radmilofelix/ElectronicFocuser/Schematic&PCB/KiCad/Regulus Focuser-V1.remote/Images/Focuser-V1.Remote-3D_View.jpg

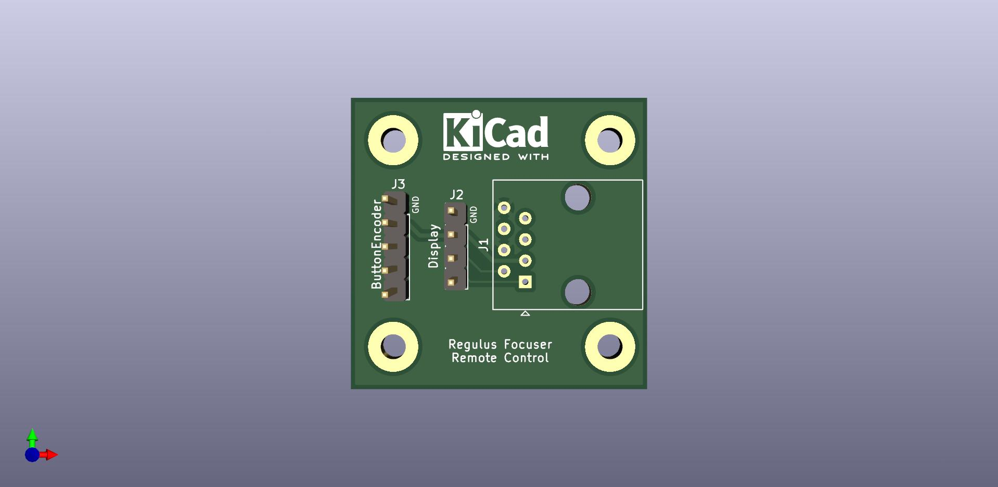
Schematic&PCB/KiCad/Regulus Focuser-V1.remote/Images/Focuser-V1.Remote-3D_View.jpg
