radmilofelix/ElectronicFocuser/Schematic&PCB/PCB/RegulusFocuser-V1.0.jpg

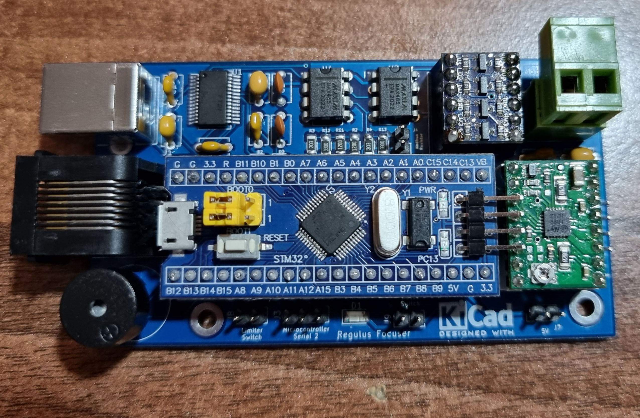
Schematic&PCB/PCB/RegulusFocuser-V1.0.jpg
