radmilofelix/ElectronicFocuser/README.md

# ElectronicFocuser
 Electronic focuser with stepper motor for telescopes
