radmilofelix/ElectronicFocuser/Schematic&PCB/KiCad/Regulus Focuser-V1.1/Errors&Enhancements/Errors&Enhancements.odt

The resistors on the i2c lines (2.2k) are pulldown instead of pullup.
