radmilofelix/ElectronicFocuser/Documents/StepperMotorDriversPinout.xlsx

A4988 | DRV8825 | STSPIN220 | STSPIN820 | STSPIN820 | STSPIN220 | DRV8825 | A4988
-ENABLE | -ENABLE | -ENABLE | -ENABLE | VMOT | VMOT | VMOT | VMOT
MS1 | M0 | MODE1 | M1 | GND | GND | GND | GND
MS2 | M1 | MODE2 | M2 | B1 | B1 | B2 | 2B
MS3 | M2 | 1 | M3 | B2 | B2 | B1 | 2A
-RESET | -RESET | 2 | -FLT | A2 | A2 | A1 | 1A
-SLEEP | -SLEEP | -STBY | -STBY | A1 | A1 | A2 | 1B
STEP | STEP | STEP/MODE3 | STEP | VCC | VCC | -FAULT [VCC] | VDD
DIR | DIR | DIR/MODE4 | DIR | GND | GND | GND | GND
