radmilofelix/ElectronicFocuser/Schematic&PCB/KiCad/Regulus Focuser-V1/Errors&Enhancements/Errors&Enhancements.odt

There are routing errors – MC pins 2, 3, 4, 6, 7, 26, 27, 28, 29, 30, 31, 32

Add details for logic level shifter, 5V pins, serial pins, motor driver pins

Add pullup resistors on the i2c lines (2.2k).

Add decoupling capacitor on the limiter switch 2.2 uF

Power from 12v to 5V ???
