radmilofelix/ElectronicFocuser/MechanicalDesigns-FreeCad/2 inch Crayford Focuser for Schmidt Cassegrain/SwitchHolders/BigMicroswitch/D3V-16-1C5/D3V-16-1C5.jpg

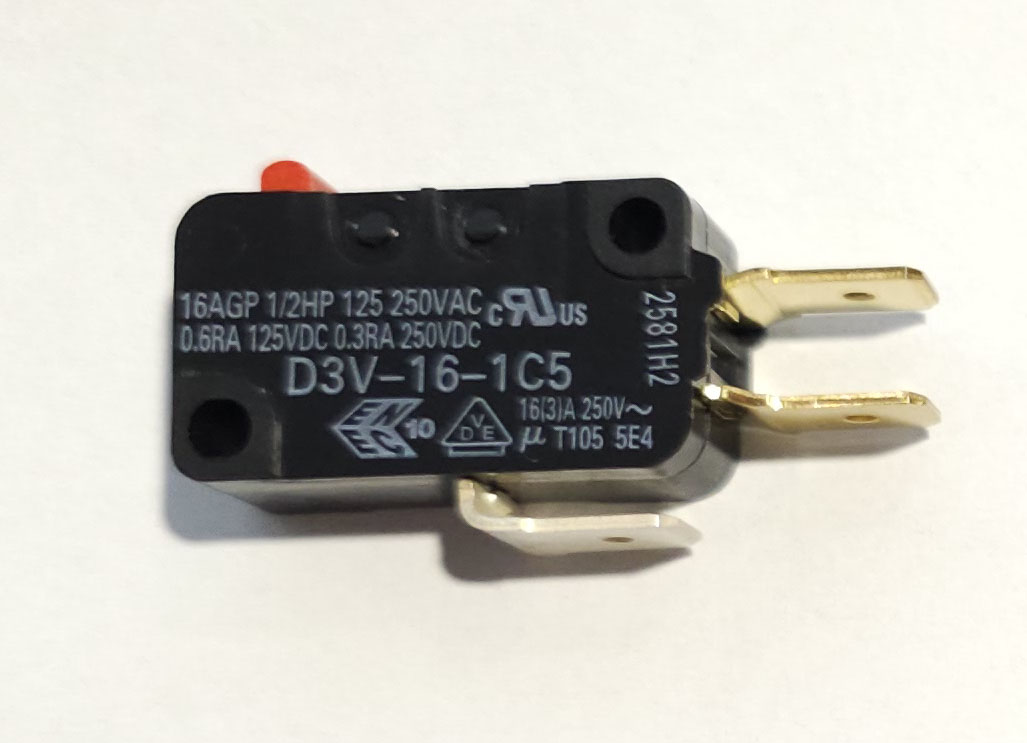
MechanicalDesigns-FreeCad/2 inch Crayford Focuser for Schmidt Cassegrain/SwitchHolders/BigMicroswitch/D3V-16-1C5/D3V-16-1C5.jpg
