radmilofelix/ElectronicFocuser/MechanicalDesigns-FreeCad/2 inch Crayford Focuser for Schmidt Cassegrain/SwitchHolders/BigMicroswitch/D3V-162-1A4/D3V-162-1A4.jpg

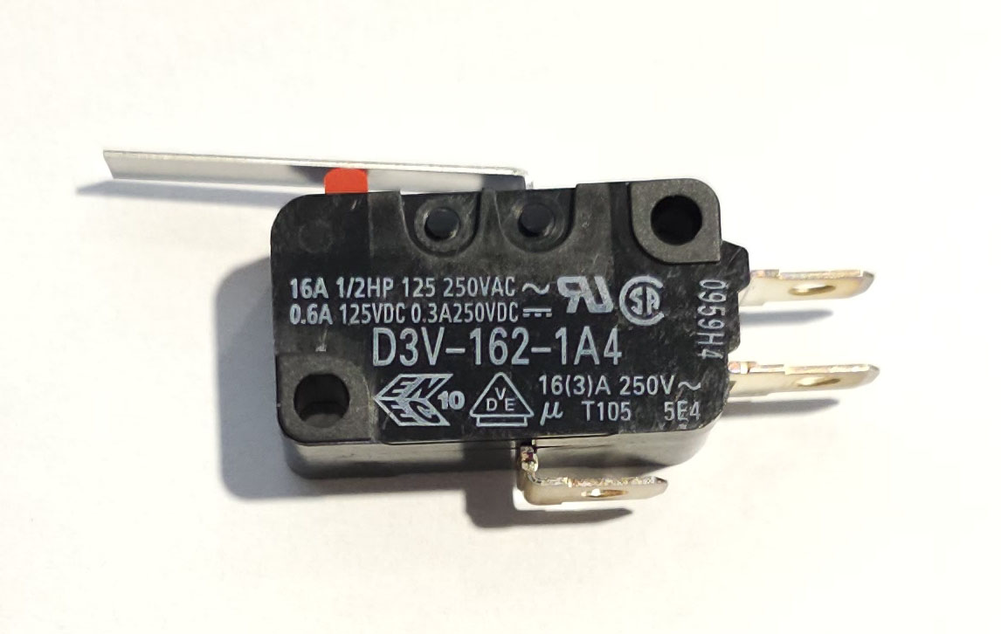
MechanicalDesigns-FreeCad/2 inch Crayford Focuser for Schmidt Cassegrain/SwitchHolders/BigMicroswitch/D3V-162-1A4/D3V-162-1A4.jpg
