radmilofelix/ElectronicFocuser/MechanicalDesigns-FreeCad/2 inch Crayford Focuser for Schmidt Cassegrain/SwitchHolders/MediumMicroswitch/SS-X-GL/SS-X-GL.jpg

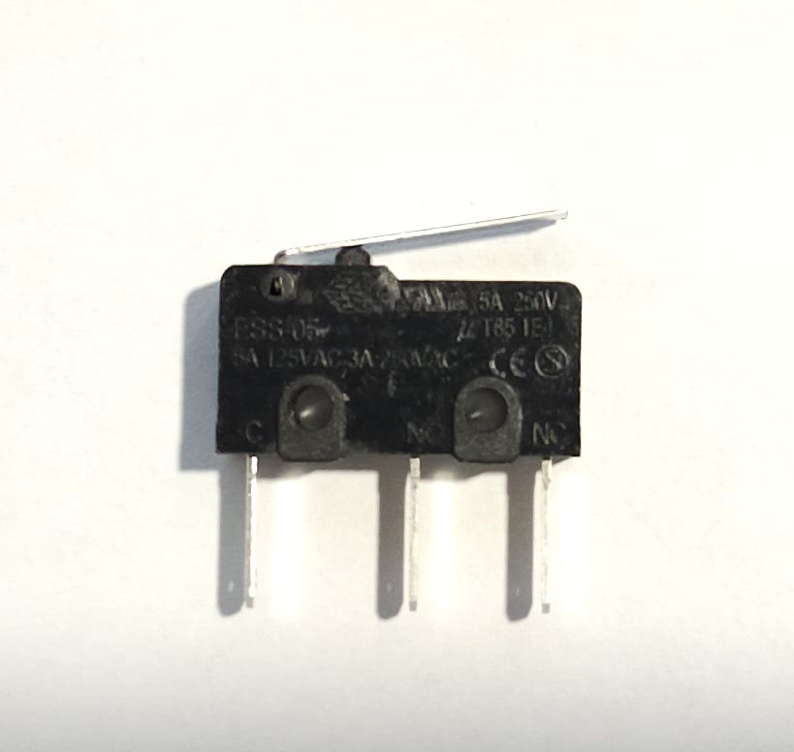
MechanicalDesigns-FreeCad/2 inch Crayford Focuser for Schmidt Cassegrain/SwitchHolders/MediumMicroswitch/SS-X-GL/SS-X-GL.jpg
