radmilofelix/ElectronicFocuser/MechanicalDesigns-FreeCad/2 inch Crayford Focuser for Schmidt Cassegrain/SwitchHolders/MediumMicroswitch/SS-X/SS-X.jpg

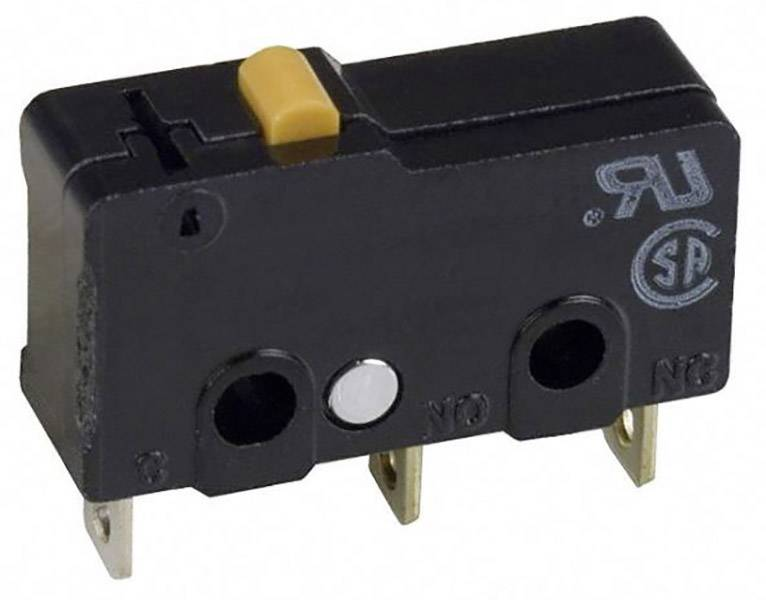
MechanicalDesigns-FreeCad/2 inch Crayford Focuser for Schmidt Cassegrain/SwitchHolders/MediumMicroswitch/SS-X/SS-X.jpg
