radmilofelix/ElectronicFocuser/MechanicalDesigns-FreeCad/2 inch Crayford Focuser for Schmidt Cassegrain/SwitchHolders/SmallMicroswitch/D2F-L/D2F-L.jpg

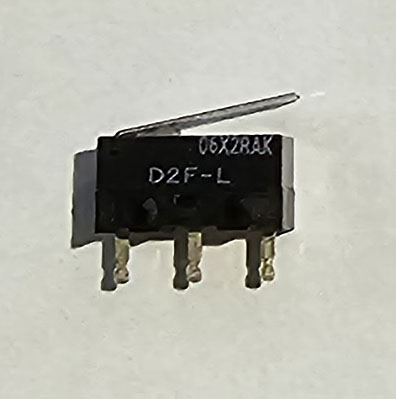
MechanicalDesigns-FreeCad/2 inch Crayford Focuser for Schmidt Cassegrain/SwitchHolders/SmallMicroswitch/D2F-L/D2F-L.jpg
