radmilofelix/ElectronicFocuser/Schematic&PCB/KiCad/Regulus Focuser-V1.1/Errors&Enhancements/I2C-resistorsChangedToPullup.jpg

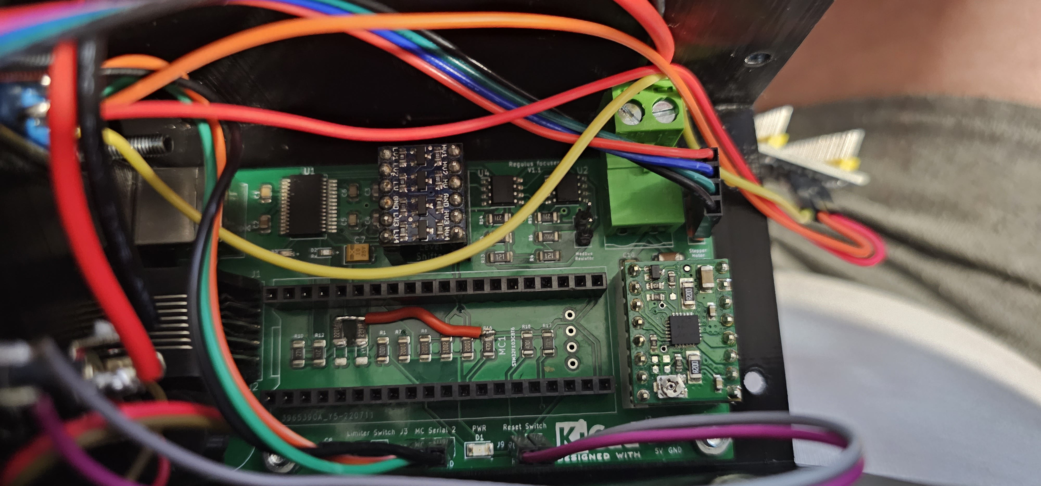
Schematic&PCB/KiCad/Regulus Focuser-V1.1/Errors&Enhancements/I2C-resistorsChangedToPullup.jpg
