radmilofelix/ElectronicFocuser/Schematic&PCB/PCB/PCB-V1.1-fixed.jpg

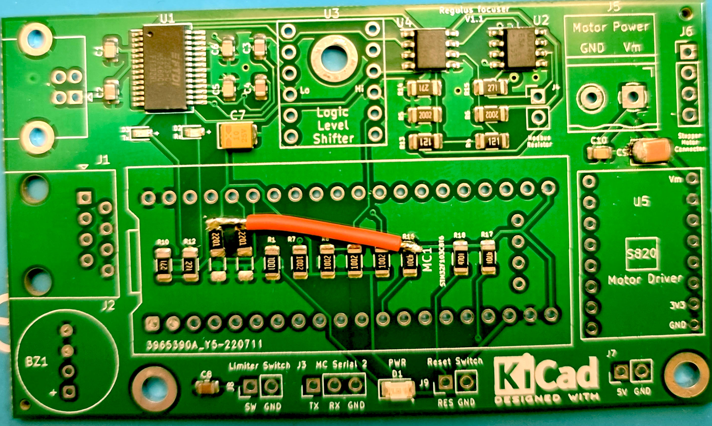
Schematic&PCB/PCB/PCB-V1.1-fixed.jpg
