radmilofelix/ElectronicFocuser/Schematic&PCB/PCB/PCB-V1.1.jpg

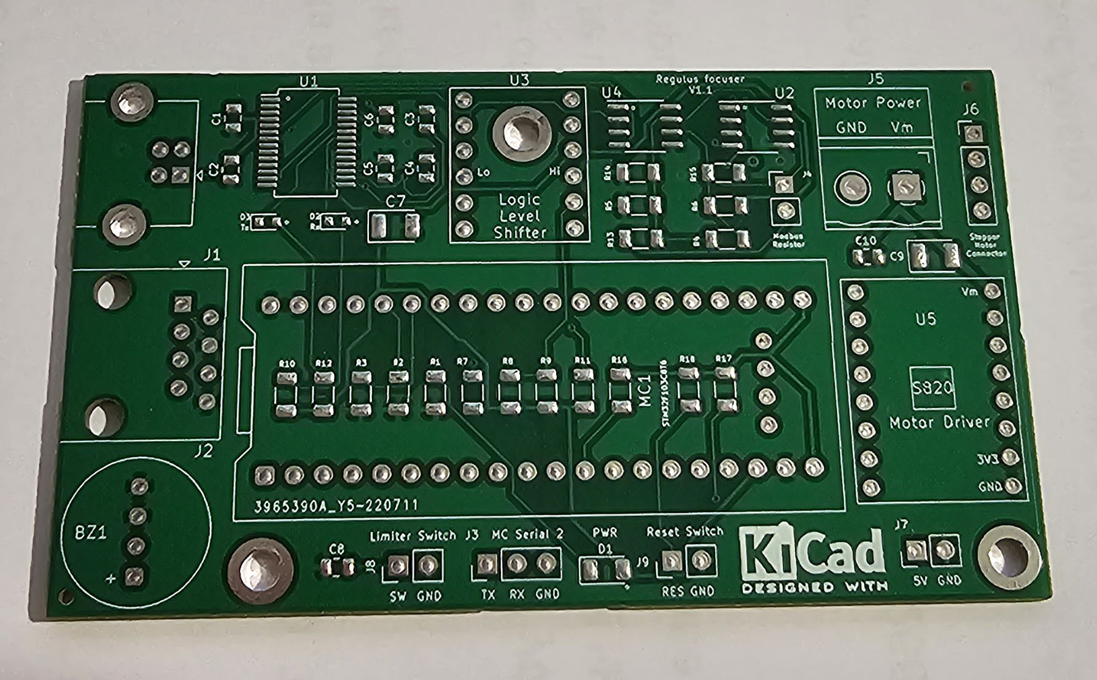
Schematic&PCB/PCB/PCB-V1.1.jpg
