radmilofelix/ElectronicFocuser/Schematic&PCB/PCB/RemoteControl-Back.jpg

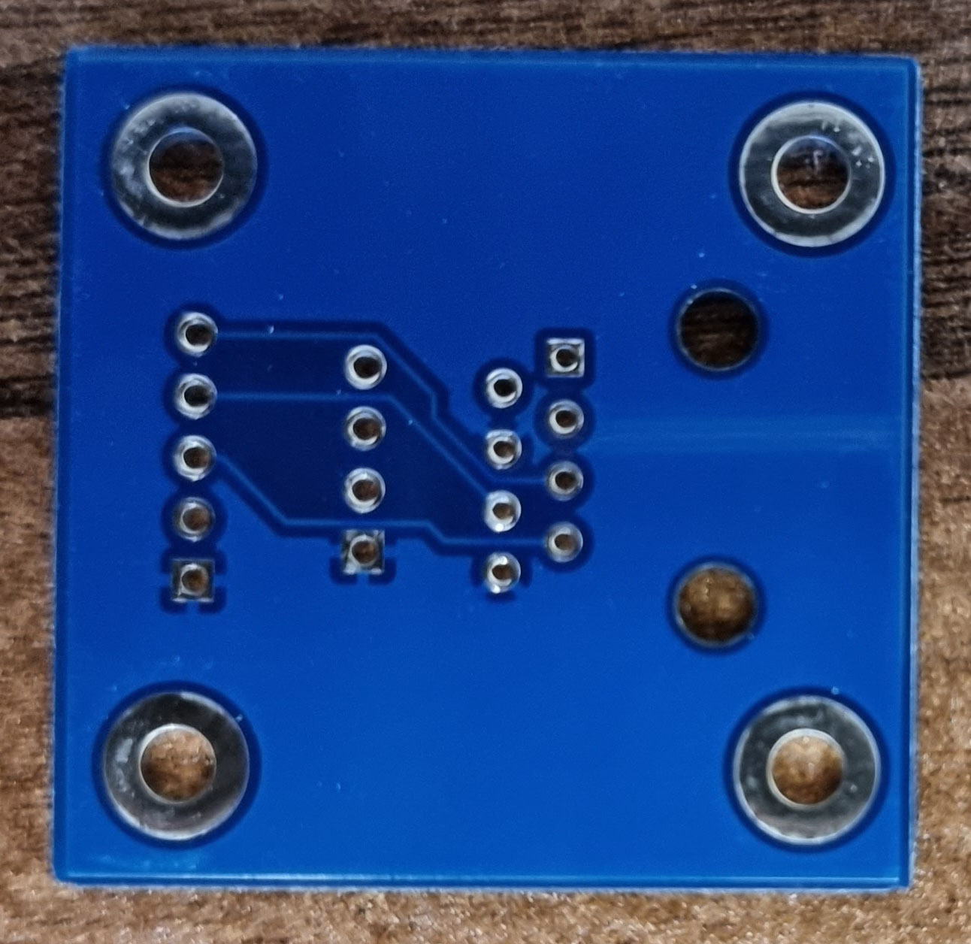
Schematic&PCB/PCB/RemoteControl-Back.jpg
