radmilofelix/ElectronicFocuser/Schematic&PCB/PCB/RemoteControl-Front.jpg

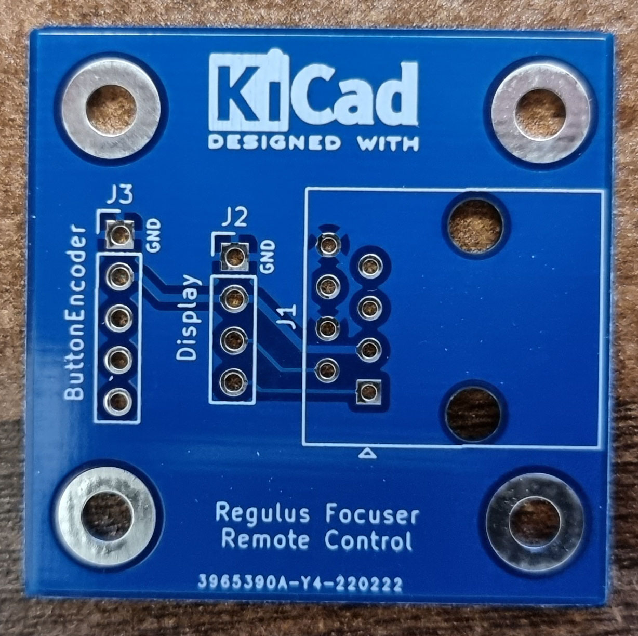
Schematic&PCB/PCB/RemoteControl-Front.jpg
