radmilofelix/ElectronicFocuser/MechanicalDesigns-FreeCad/2 inch Crayford Focuser for Schmidt Cassegrain/Case-MainPart.FCStd

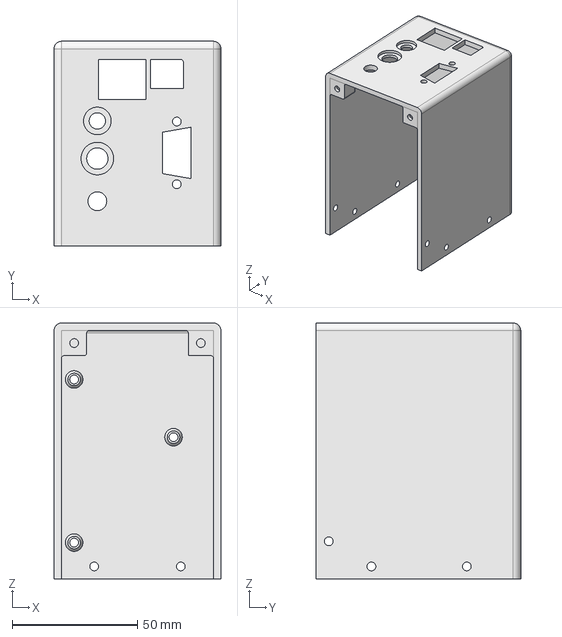
[picture p13: CAD file, 2023-12-28]
MechanicalDesigns-FreeCad/2 inch Crayford Focuser for Schmidt Cassegrain/Case-MainPart.FCStd
66.5 x 81.5 x 102.0 mm
