radmilofelix/ElectronicFocuser/MechanicalDesigns-FreeCad/Newt-254-F_4-RackAndPinion-LowProfile-focuser/Case-MainPart.FCStd

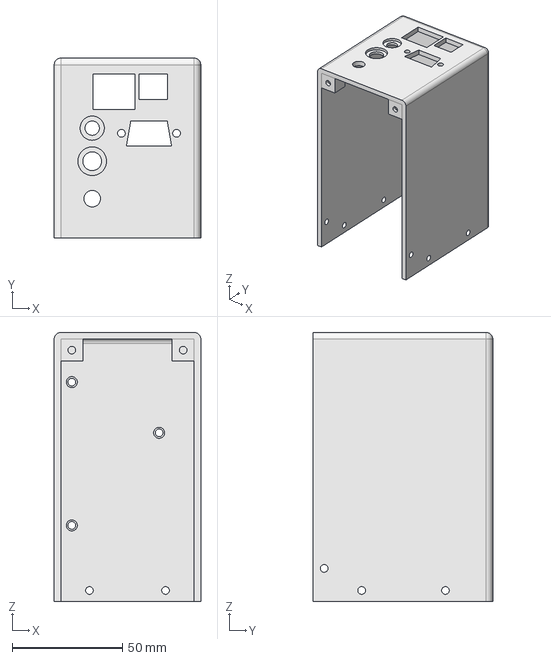
[picture p14: CAD file, 2023-12-28]
MechanicalDesigns-FreeCad/Newt-254-F_4-RackAndPinion-LowProfile-focuser/Case-MainPart.FCStd
66.5 x 81.5 x 122.0 mm
