radmilofelix/ElectronicFocuser/MechanicalDesigns-FreeCad/Newt-254-F_4-RackAndPinion-LowProfile-focuser/Case-MainPart-Work.FCStd

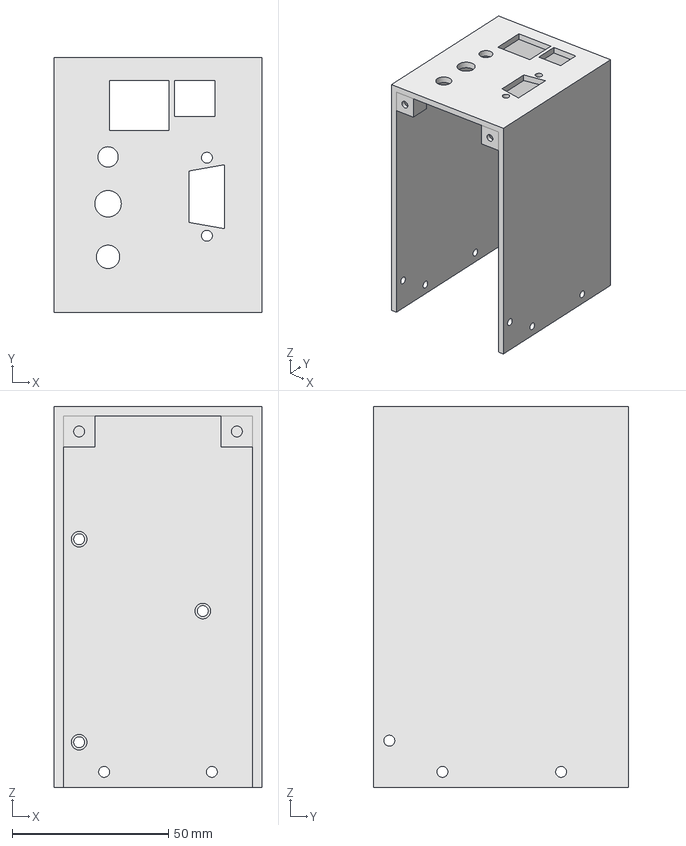
[picture p15: CAD file, 2023-12-28]
MechanicalDesigns-FreeCad/Newt-254-F_4-RackAndPinion-LowProfile-focuser/Case-MainPart-Work.FCStd
66.5 x 81.5 x 122.0 mm
