radmilofelix/ElectronicFocuser/MechanicalDesigns-FreeCad/2 inch Crayford Focuser for Schmidt Cassegrain/SwitchHolders/BigMicroswitch/D3V-16-1C5/SwitchHolderPerpendicular-D3V-15-1C5-Body.stl

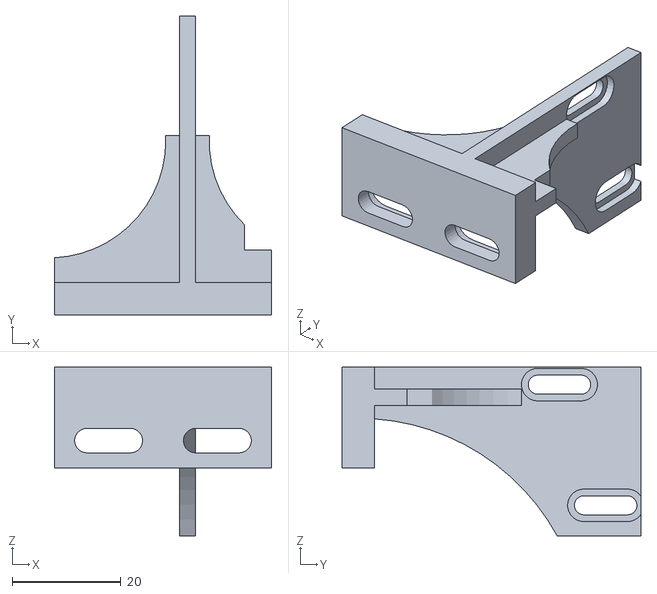
[picture p16: CAD file, 2023-06-21]
MechanicalDesigns-FreeCad/2 inch Crayford Focuser for Schmidt Cassegrain/SwitchHolders/BigMicroswitch/D3V-16-1C5/SwitchHolderPerpendicular-D3V-15-1C5-Body.stl
40.0 x 55.0 x 31.0
