radmilofelix/ElectronicFocuser/MechanicalDesigns-FreeCad/2 inch Crayford Focuser for Schmidt Cassegrain/SwitchHolders/BigMicroswitch/D3V-162-1A4/SwitchHolderPerpendicular-D3V-162-1A4-Body.stl

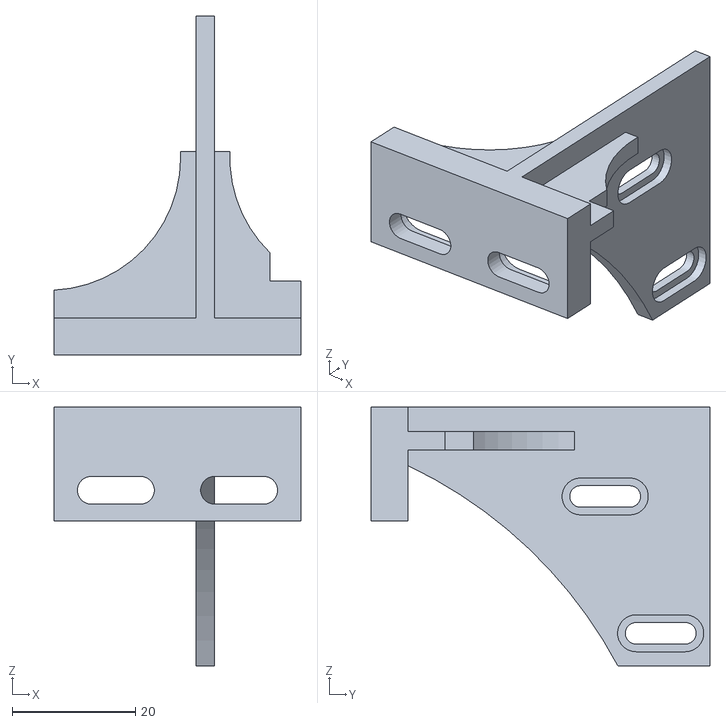
[picture p17: CAD file, 2023-06-21]
MechanicalDesigns-FreeCad/2 inch Crayford Focuser for Schmidt Cassegrain/SwitchHolders/BigMicroswitch/D3V-162-1A4/SwitchHolderPerpendicular-D3V-162-1A4-Body.stl
40.0 x 55.0 x 42.0
