radmilofelix/ElectronicFocuser/MechanicalDesigns-FreeCad/2 inch Crayford Focuser for Schmidt Cassegrain/SwitchHolders/MediumMicroswitch/SS-X-GL/SwitchHolderPerpendicular-SS-X-GL.FCStd

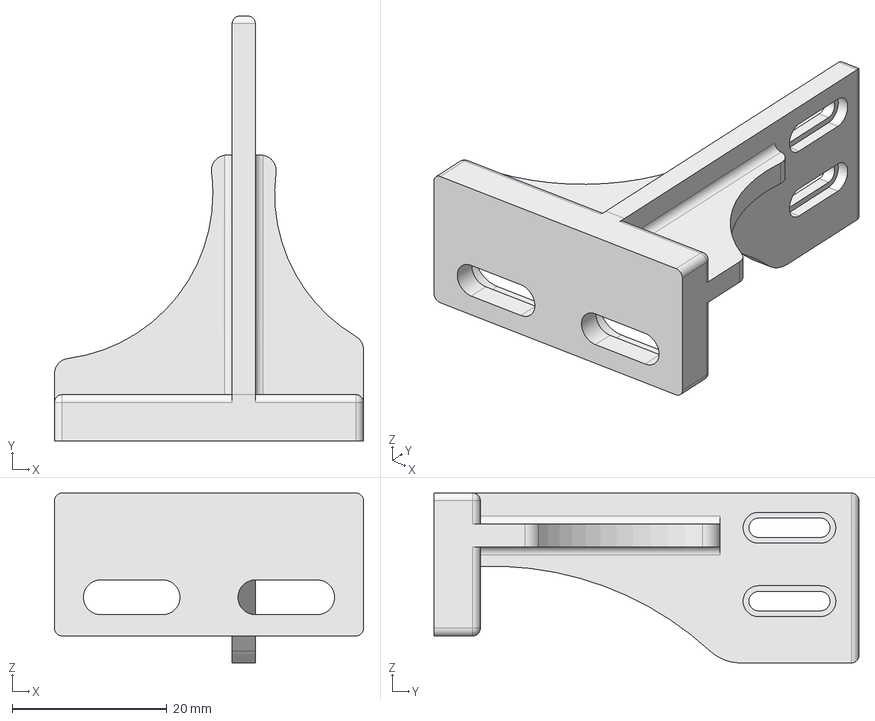
[picture p18: CAD file, 2023-06-21]
MechanicalDesigns-FreeCad/2 inch Crayford Focuser for Schmidt Cassegrain/SwitchHolders/MediumMicroswitch/SS-X-GL/SwitchHolderPerpendicular-SS-X-GL.FCStd
40.0 x 55.0 x 22.0 mm
