radmilofelix/ElectronicFocuser/MechanicalDesigns-FreeCad/2 inch Crayford Focuser for Schmidt Cassegrain/SwitchHolders/MediumMicroswitch/SS-X/SwitchHolderParallel-SS-X.FCStd

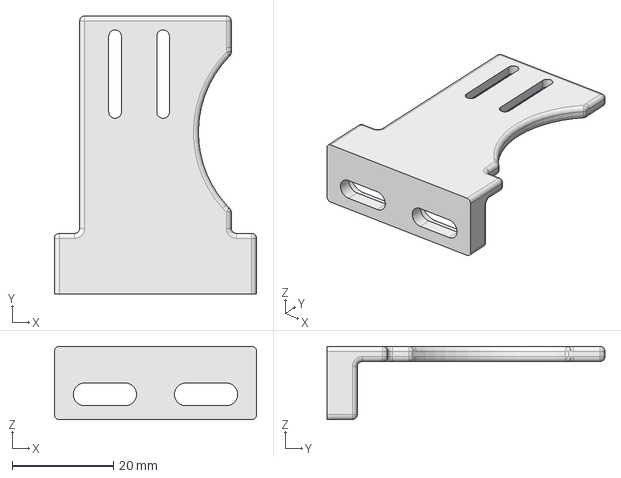
[picture p19: CAD file, 2023-06-21]
MechanicalDesigns-FreeCad/2 inch Crayford Focuser for Schmidt Cassegrain/SwitchHolders/MediumMicroswitch/SS-X/SwitchHolderParallel-SS-X.FCStd
40.0 x 55.0 x 14.5 mm
