radmilofelix/ElectronicFocuser/MechanicalDesigns-FreeCad/2 inch Crayford Focuser for Schmidt Cassegrain/SwitchHolders/SmallMicroswitch/D2F-L/SwitchHolderPerpendicular-D2F-L.FCStd

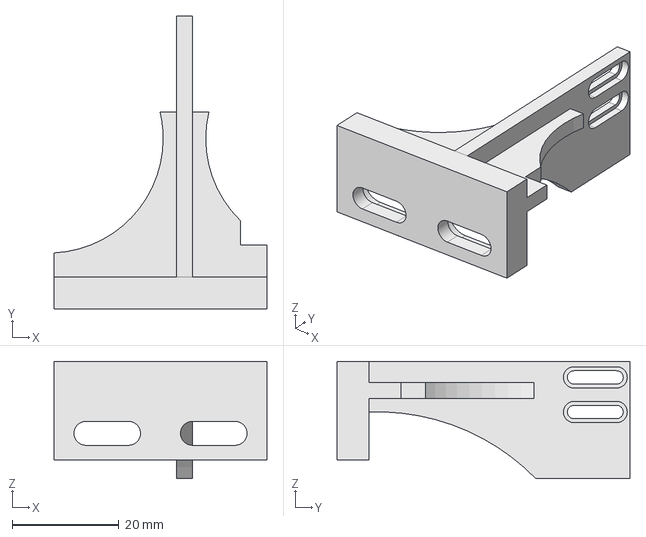
[picture p20: CAD file, 2023-06-21]
MechanicalDesigns-FreeCad/2 inch Crayford Focuser for Schmidt Cassegrain/SwitchHolders/SmallMicroswitch/D2F-L/SwitchHolderPerpendicular-D2F-L.FCStd
40.0 x 55.0 x 22.0 mm
