radmilofelix/ElectronicFocuser/MechanicalDesigns-FreeCad/Newt-254-F_4-Crayford-focuser/MotorHolder.FCStd

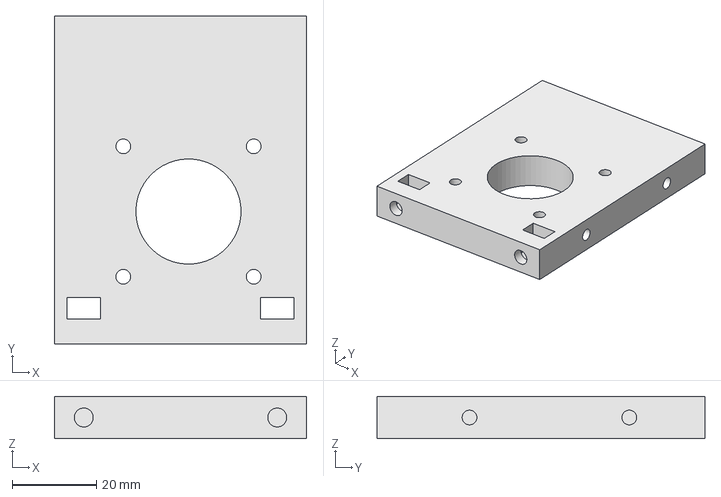
[picture p21: CAD file, 2023-12-25]
MechanicalDesigns-FreeCad/Newt-254-F_4-Crayford-focuser/MotorHolder.FCStd
60.0 x 78.0 x 10.0 mm
