radmilofelix/ElectronicFocuser/MechanicalDesigns-FreeCad/RemoteControl/FocuserRemoteCase-lid.FCStd

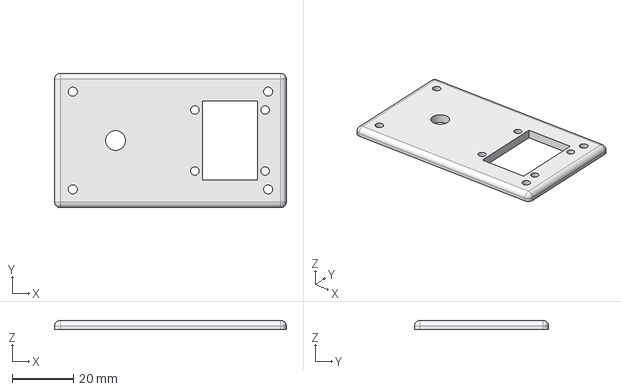
[picture p22: CAD file, 2023-06-21]
MechanicalDesigns-FreeCad/RemoteControl/FocuserRemoteCase-lid.FCStd
76.0 x 44.0 x 3.00 mm
