radmilofelix/ElectronicFocuser/MechanicalDesigns-FreeCad/Newt-254-F_4-RackAndPinion-LowProfile-focuser/HalfAdapterMotorHolder.FCStd

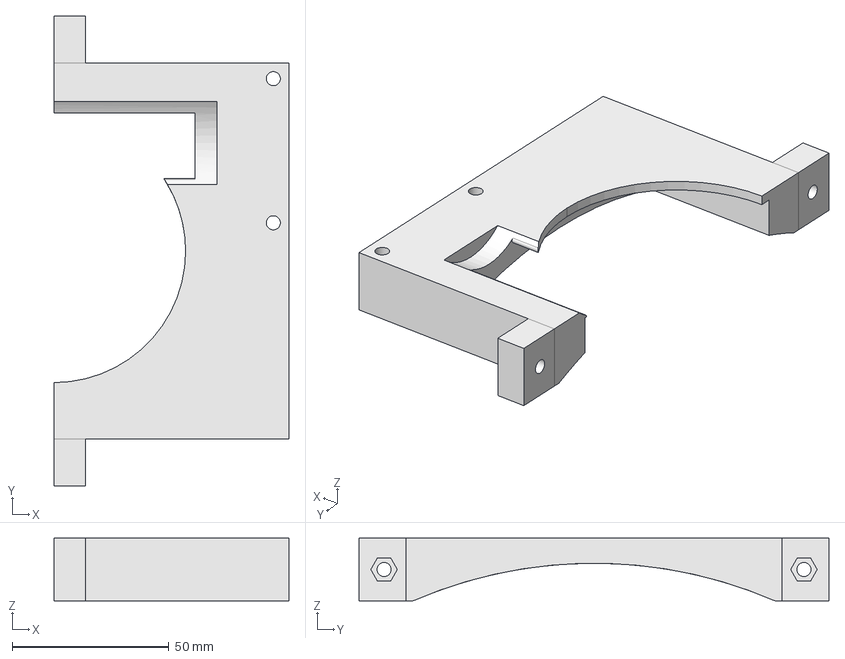
[picture p23: CAD file, 2023-12-28]
MechanicalDesigns-FreeCad/Newt-254-F_4-RackAndPinion-LowProfile-focuser/HalfAdapterMotorHolder.FCStd
75.0 x 150.0 x 20.0 mm
