radmilofelix/ElectronicFocuser/MechanicalDesigns-FreeCad/RemoteControl/FocuserRemoteCaseThin.FCStd

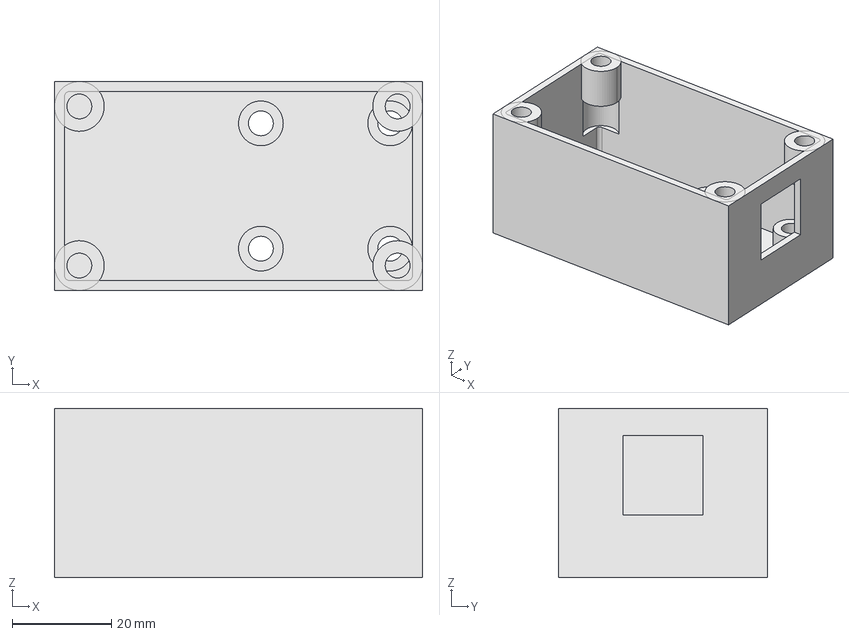
[picture p24: CAD file, 2023-06-21]
MechanicalDesigns-FreeCad/RemoteControl/FocuserRemoteCaseThin.FCStd
74.0 x 42.0 x 34.0 mm
