radmilofelix/ElectronicFocuser/MechanicalDesigns-FreeCad/Newt-254-F_4-RackAndPinion-LowProfile-focuser/Case-Lid-Body.stl

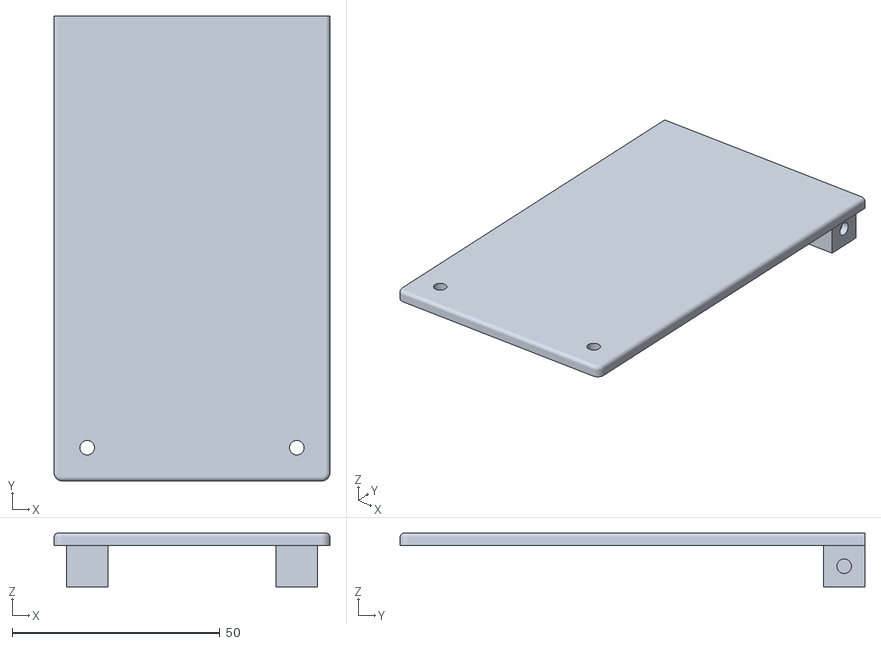
[picture p25: CAD file, 2023-12-28]
MechanicalDesigns-FreeCad/Newt-254-F_4-RackAndPinion-LowProfile-focuser/Case-Lid-Body.stl
66.5 x 112.0 x 13.0
