radmilofelix/ElectronicFocuser/MechanicalDesigns-FreeCad/RemoteControl/FocuserRemoteCase.FCStd

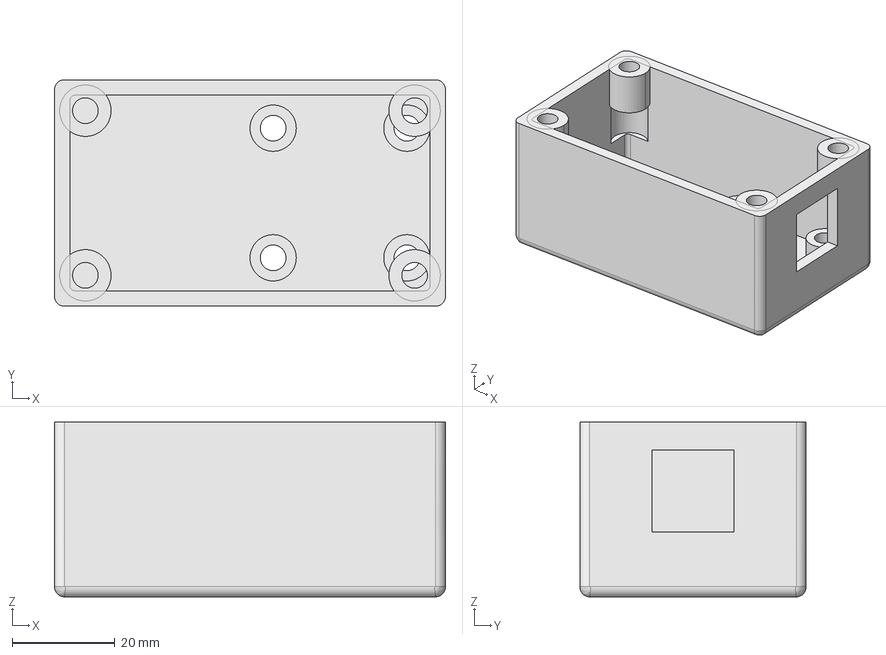
[picture p26: CAD file, 2023-06-21]
MechanicalDesigns-FreeCad/RemoteControl/FocuserRemoteCase.FCStd
76.0 x 44.0 x 34.0 mm
