radmilofelix/ElectronicFocuser/MechanicalDesigns-FreeCad/Newt-254-F_4-Crayford-focuser/HalfAdapterMotorHolder.FCStd

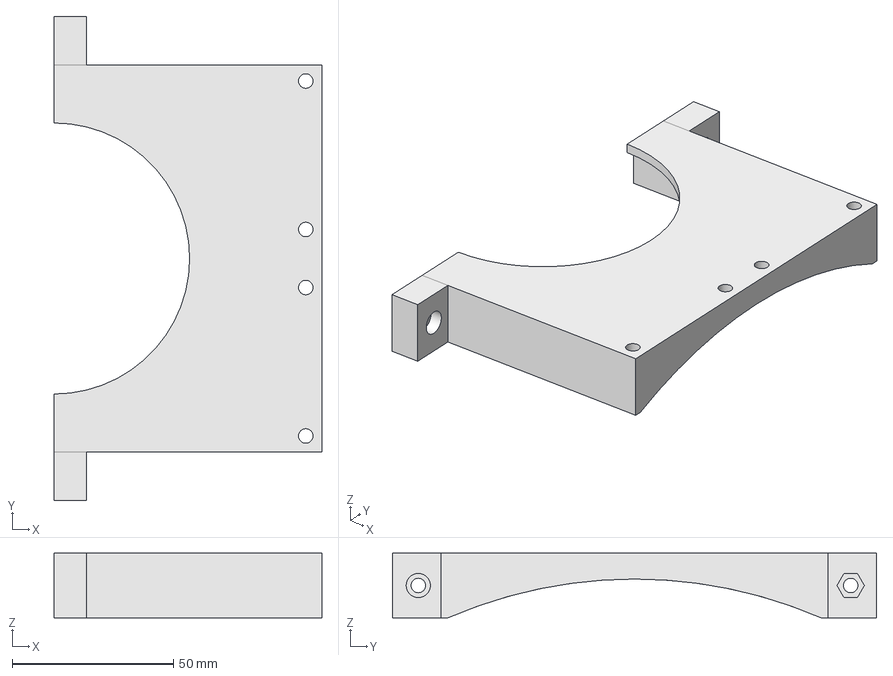
[picture p27: CAD file, 2023-06-21]
MechanicalDesigns-FreeCad/Newt-254-F_4-Crayford-focuser/HalfAdapterMotorHolder.FCStd
83.0 x 150.0 x 20.0 mm
