radmilofelix/ElectronicFocuser/MechanicalDesigns-FreeCad/2 inch Crayford Focuser for Schmidt Cassegrain/HalfAdapterSwitchHolder.FCStd

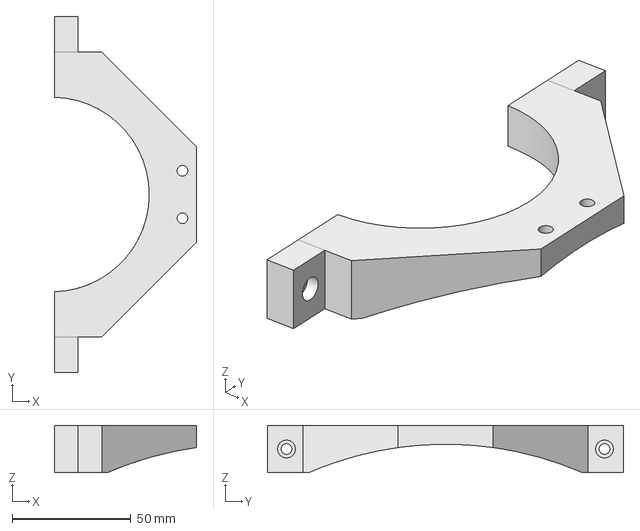
[picture p28: CAD file, 2023-06-21]
MechanicalDesigns-FreeCad/2 inch Crayford Focuser for Schmidt Cassegrain/HalfAdapterSwitchHolder.FCStd
60.0 x 150.0 x 20.0 mm
