radmilofelix/ElectronicFocuser/MechanicalDesigns-FreeCad/RemoteControl/FocuserRemoteCase-lid-Thin.FCStd

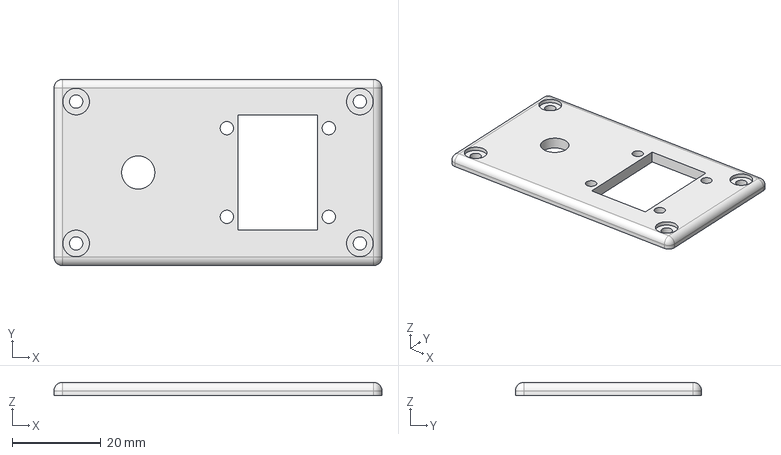
[picture p30: CAD file, 2023-06-21]
MechanicalDesigns-FreeCad/RemoteControl/FocuserRemoteCase-lid-Thin.FCStd
74.0 x 42.0 x 3.00 mm
