radmilofelix/ElectronicFocuser/MechanicalDesigns-FreeCad/Newt-254-F_4-RackAndPinion-LowProfile-focuser/SwitchHolderPerpendicular-Body.stl

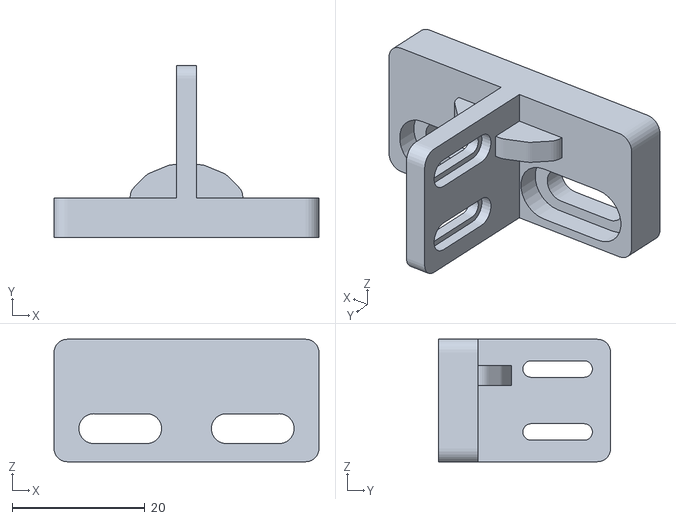
[picture p31: CAD file, 2023-12-28]
MechanicalDesigns-FreeCad/Newt-254-F_4-RackAndPinion-LowProfile-focuser/SwitchHolderPerpendicular-Body.stl
40.0 x 26.0 x 18.5
