radmilofelix/ElectronicFocuser/MechanicalDesigns-FreeCad/Newt-254-F_4-Crayford-focuser/HalfAdapterSwitchHolder.FCStd

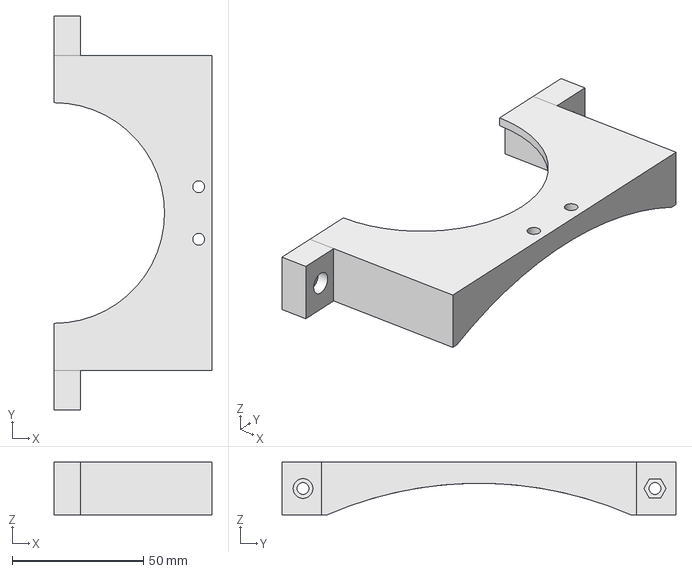
[picture p33: CAD file, 2023-06-21]
MechanicalDesigns-FreeCad/Newt-254-F_4-Crayford-focuser/HalfAdapterSwitchHolder.FCStd
60.0 x 150.0 x 20.0 mm
