radmilofelix/ElectronicFocuser/MechanicalDesigns-FreeCad/2 inch Crayford Focuser for Schmidt Cassegrain/HalfAdapterMotorHolder.FCStd

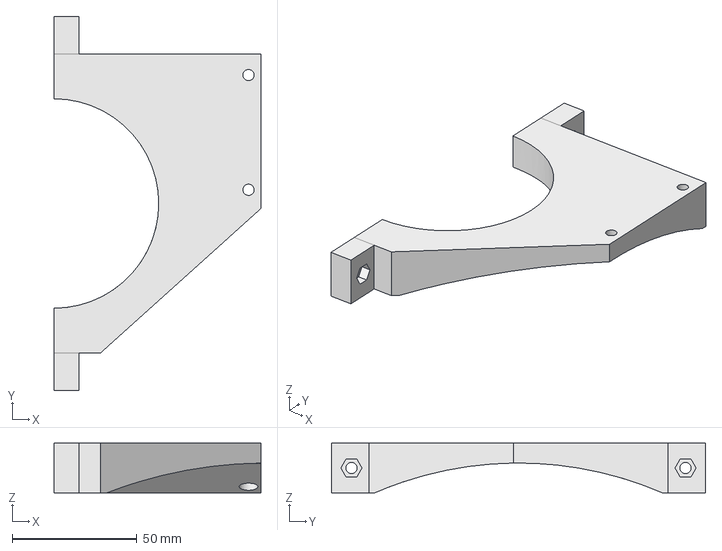
[picture p34: CAD file, 2023-06-21]
MechanicalDesigns-FreeCad/2 inch Crayford Focuser for Schmidt Cassegrain/HalfAdapterMotorHolder.FCStd
83.0 x 150.0 x 20.0 mm
