radmilofelix/ElectronicFocuser/MechanicalDesigns-FreeCad/Newt-254-F_4-Crayford-focuser/SwitchHolderPerpendicular.FCStd

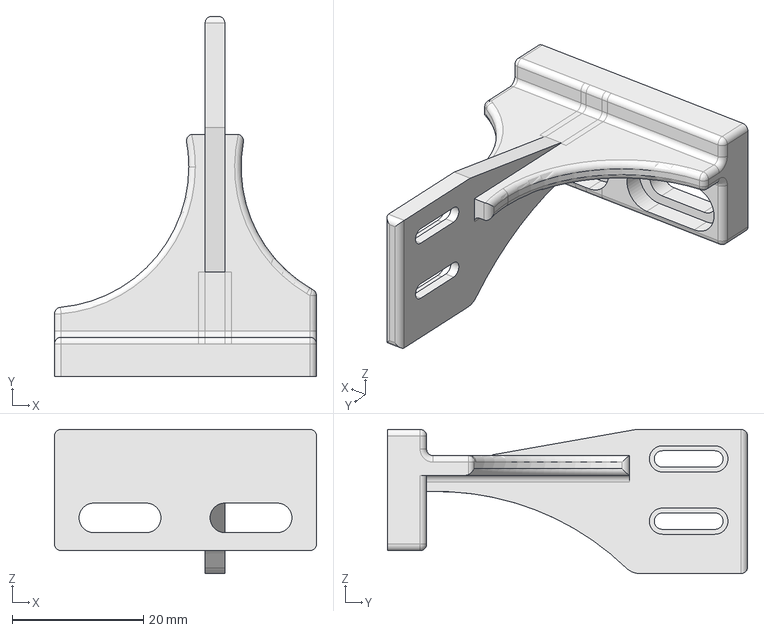
[picture p35: CAD file, 2023-06-21]
MechanicalDesigns-FreeCad/Newt-254-F_4-Crayford-focuser/SwitchHolderPerpendicular.FCStd
40.0 x 55.0 x 22.0 mm
