radmilofelix/ElectronicFocuser/MechanicalDesigns-FreeCad/Newt-254-F_4-RackAndPinion-LowProfile-focuser/HalfAdapterSwitchHolder-Body.stl

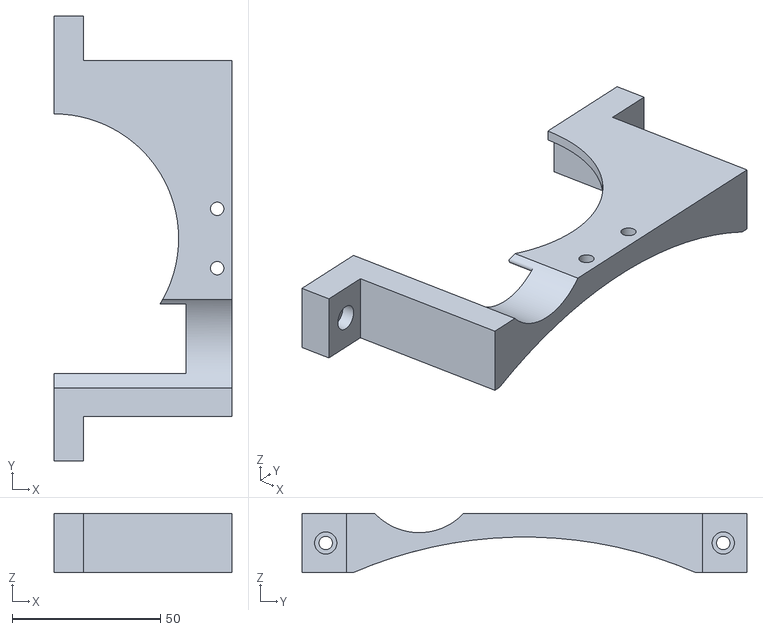
[picture p36: CAD file, 2023-12-28]
MechanicalDesigns-FreeCad/Newt-254-F_4-RackAndPinion-LowProfile-focuser/HalfAdapterSwitchHolder-Body.stl
60.0 x 150.0 x 20.0
