radmilofelix/ElectronicFocuser/MechanicalDesigns-FreeCad/Newt-254-F_4-RackAndPinion-LowProfile-focuser/HalfAdapterMotorHolder-Body.stl

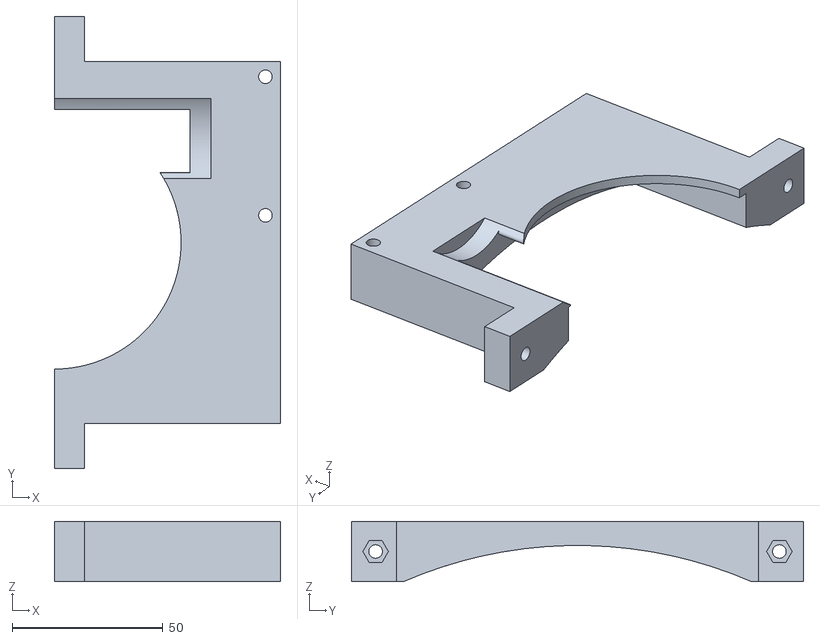
[picture p37: CAD file, 2023-12-25]
MechanicalDesigns-FreeCad/Newt-254-F_4-RackAndPinion-LowProfile-focuser/HalfAdapterMotorHolder-Body.stl
75.0 x 150.0 x 20.0
