radmilofelix/ElectronicFocuser/(list of files, cad)

Other CAD files:
MechanicalDesigns-FreeCad/2 inch Crayford Focuser for Schmidt Cassegrain/Case-MainPart-Body.stl
MechanicalDesigns-FreeCad/Newt-254-F_4-RackAndPinion-LowProfile-focuser/Case-MainPart-Body.stl
MechanicalDesigns-FreeCad/Newt-254-F_4-RackAndPinion-LowProfile-focuser/MotorHolder.FCStd
MechanicalDesigns-FreeCad/2 inch Crayford Focuser for Schmidt Cassegrain/MotorHolder.FCStd
MechanicalDesigns-FreeCad/2 inch Crayford Focuser for Schmidt Cassegrain/SwitchHolders/BigMicroswitch/D3V-16-1C5/SwitchHolderPerpendicular-D3V-15-1C5.FCStd
MechanicalDesigns-FreeCad/2 inch Crayford Focuser for Schmidt Cassegrain/SwitchHolders/BigMicroswitch/D3V-162-1A4/SwitchHolderPerpendicular-D3V-162-1A4.FCStd
MechanicalDesigns-FreeCad/2 inch Crayford Focuser for Schmidt Cassegrain/SwitchHolders/MediumMicroswitch/SS-X-GL/SwitchHolderPerpendicular-SS-X-GL-Body.stl
MechanicalDesigns-FreeCad/2 inch Crayford Focuser for Schmidt Cassegrain/SwitchHolders/SmallMicroswitch/D2F-L/SwitchHolderPerpendicular-D2F-L-Body.stl
MechanicalDesigns-FreeCad/Newt-254-F_4-Crayford-focuser/MotorHolderNew.FCStd
MechanicalDesigns-FreeCad/2 inch Crayford Focuser for Schmidt Cassegrain/MotorHolder-Body.stl
MechanicalDesigns-FreeCad/Newt-254-F_4-RackAndPinion-LowProfile-focuser/Case-Lid.FCStd
MechanicalDesigns-FreeCad/RemoteControl/FocuserRemoteCaseThin-Body.stl
MechanicalDesigns-FreeCad/2 inch Crayford Focuser for Schmidt Cassegrain/HalfAdapterSwitchHolder-Body.stl
MechanicalDesigns-FreeCad/RemoteControl/FocuserRemoteCase-lid-Thin-Body.stl
MechanicalDesigns-FreeCad/Newt-254-F_4-RackAndPinion-LowProfile-focuser/MotorHolder-New-Body.stl
MechanicalDesigns-FreeCad/RemoteControl/FocuserRemoteCase-Body.stl
MechanicalDesigns-FreeCad/2 inch Crayford Focuser for Schmidt Cassegrain/Case-Lid-Body.stl
MechanicalDesigns-FreeCad/2 inch Crayford Focuser for Schmidt Cassegrain/HalfAdapterMotorHolder-Body.stl
MechanicalDesigns-FreeCad/Newt-254-F_4-RackAndPinion-LowProfile-focuser/MotorHolder-New.FCStd
MechanicalDesigns-FreeCad/Newt-254-F_4-RackAndPinion-LowProfile-focuser/HalfAdapterSwitchHolder.FCStd
MechanicalDesigns-FreeCad/Newt-254-F_4-RackAndPinion-LowProfile-focuser/MotorHolder-Body.stl
MechanicalDesigns-FreeCad/Newt-254-F_4-Crayford-focuser/HalfAdapterMotorHolder.stl
MechanicalDesigns-FreeCad/Newt-254-F_4-Crayford-focuser/HalfAdapterSwitchHolder.stl
MechanicalDesigns-FreeCad/Newt-254-F_4-Crayford-focuser/SwitchHolder-Old.FCStd
MechanicalDesigns-FreeCad/Newt-254-F_4-Crayford-focuser/SwitchHolderPerpendicular-Old.FCStd
MechanicalDesigns-FreeCad/Newt-254-F_4-Crayford-focuser/SwitchHolderPerpendicular.stl
MechanicalDesigns-FreeCad/Newt-254-F_4-Crayford-focuser/SwitchHolderPerpendicularOld1.FCStd
