radmilofelix/ElectronicFocuser/Schematic&PCB/KiCad/Regulus Focuser-V1.remote/Images/Focuser-V1.Remote-Back.pdf

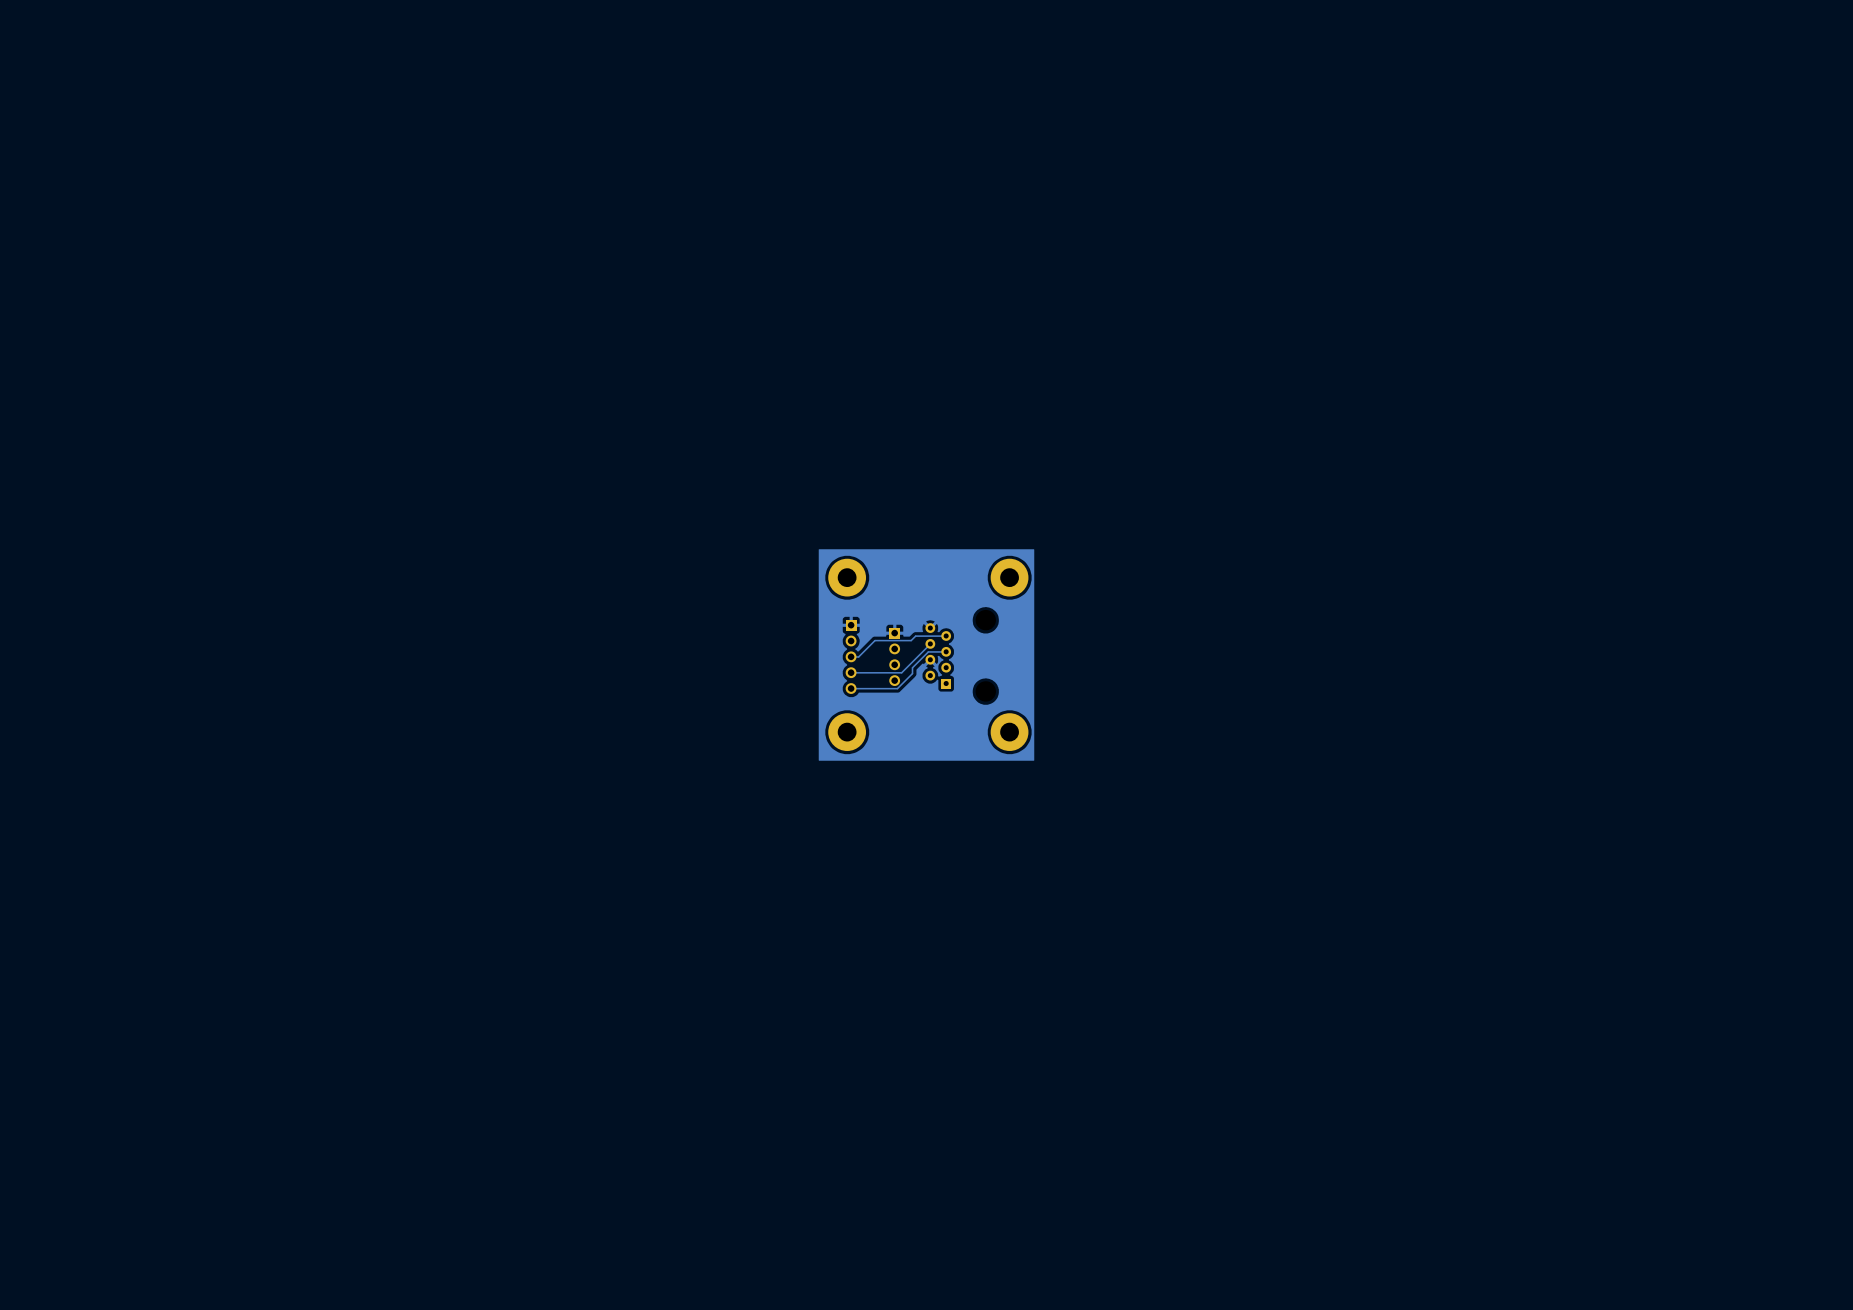
[picture p38: page 1]
