radmilofelix/ElectronicFocuser/Schematic&PCB/KiCad/Regulus Focuser-V1.remote/Images/Focuser-V1.Remote.pdf

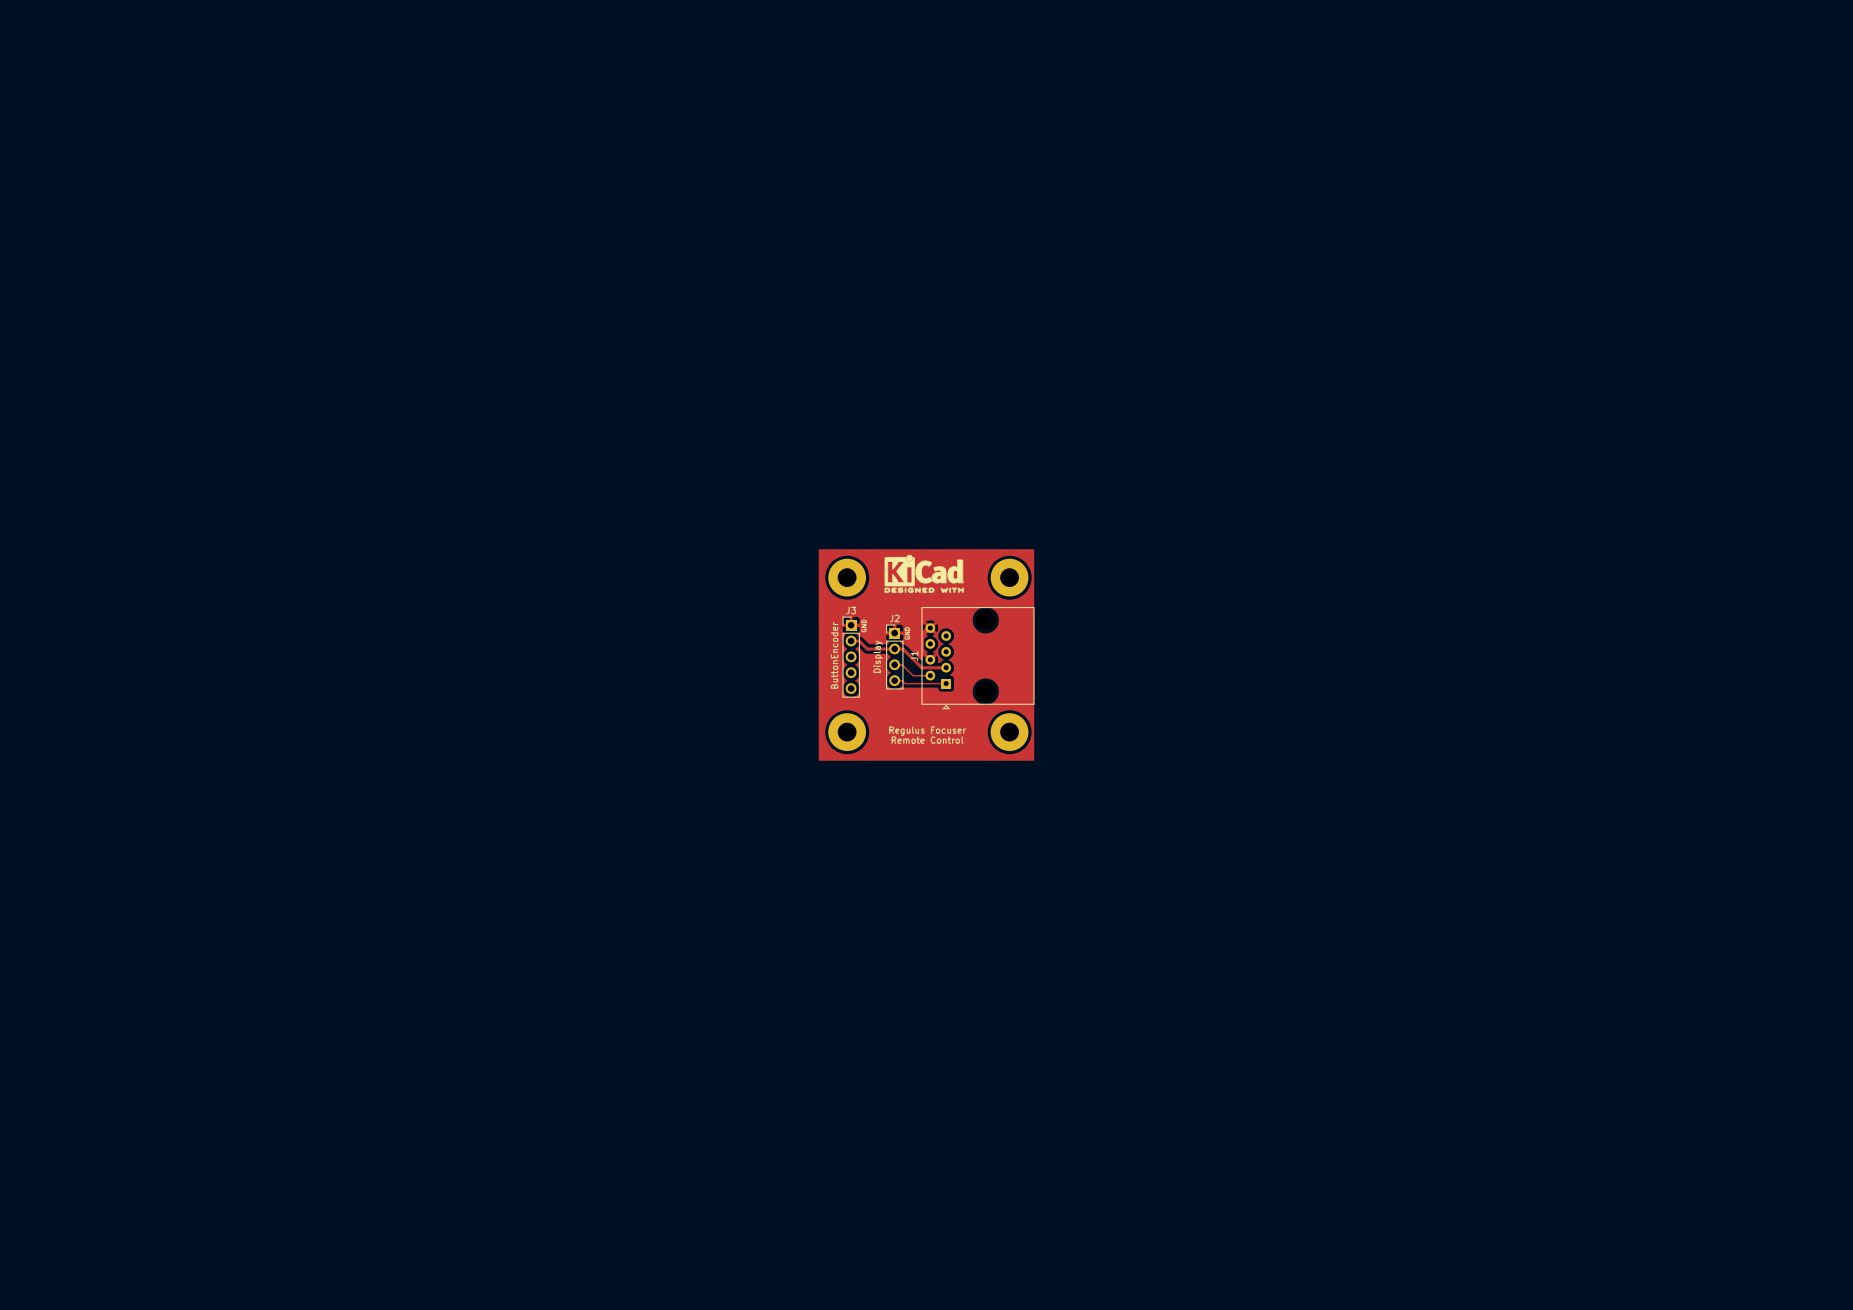
[picture p39: page 1]
