radmilofelix/ElectronicFocuser/Schematic&PCB/KiCad/Regulus Focuser-V1/Images/RegulusFocuser-V1-Back.pdf

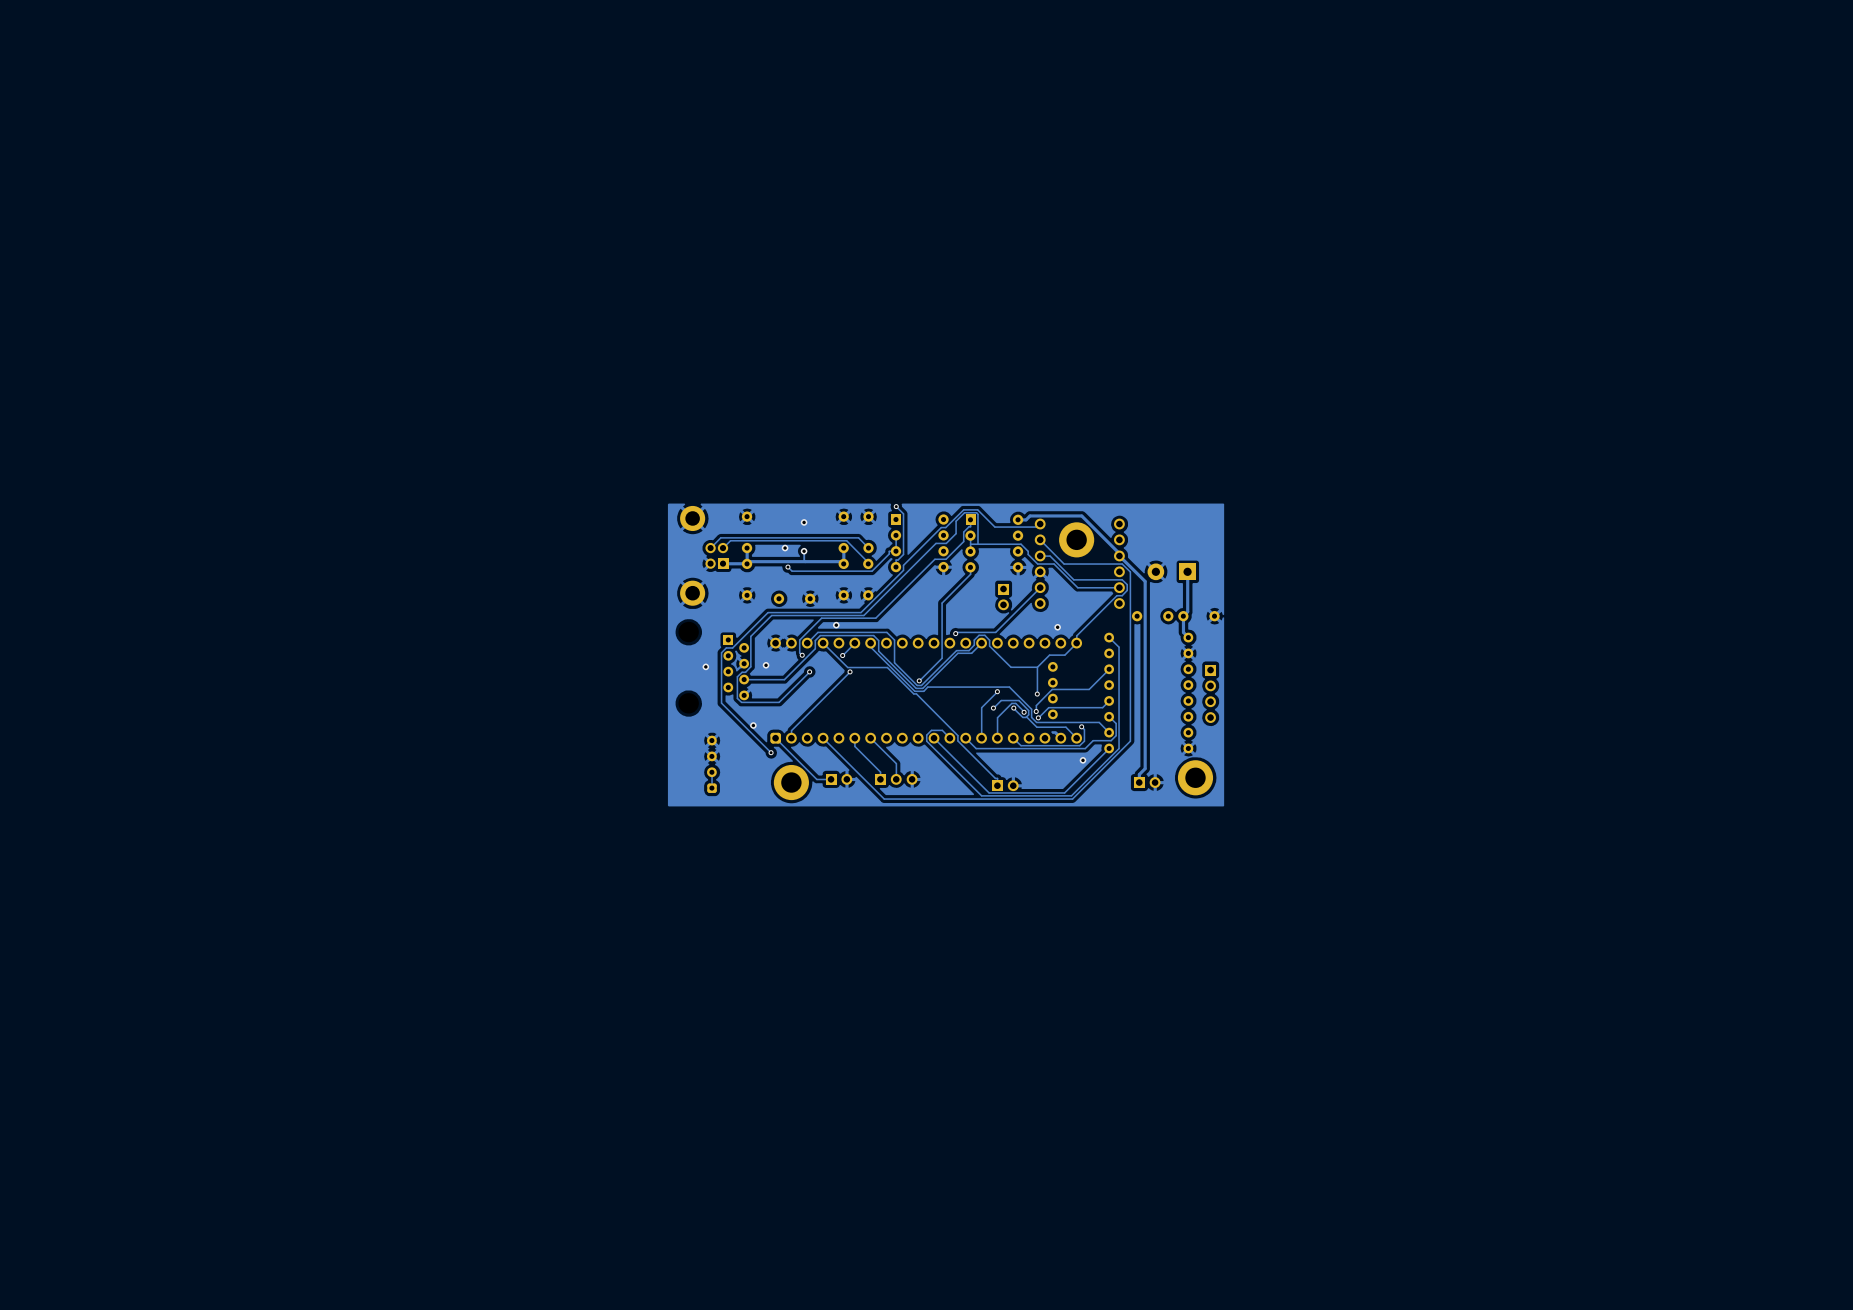
[picture p40: page 1]
