radmilofelix/ElectronicFocuser/Schematic&PCB/KiCad/Regulus Focuser-V1/Images/RegulusFocuser-V1.pdf

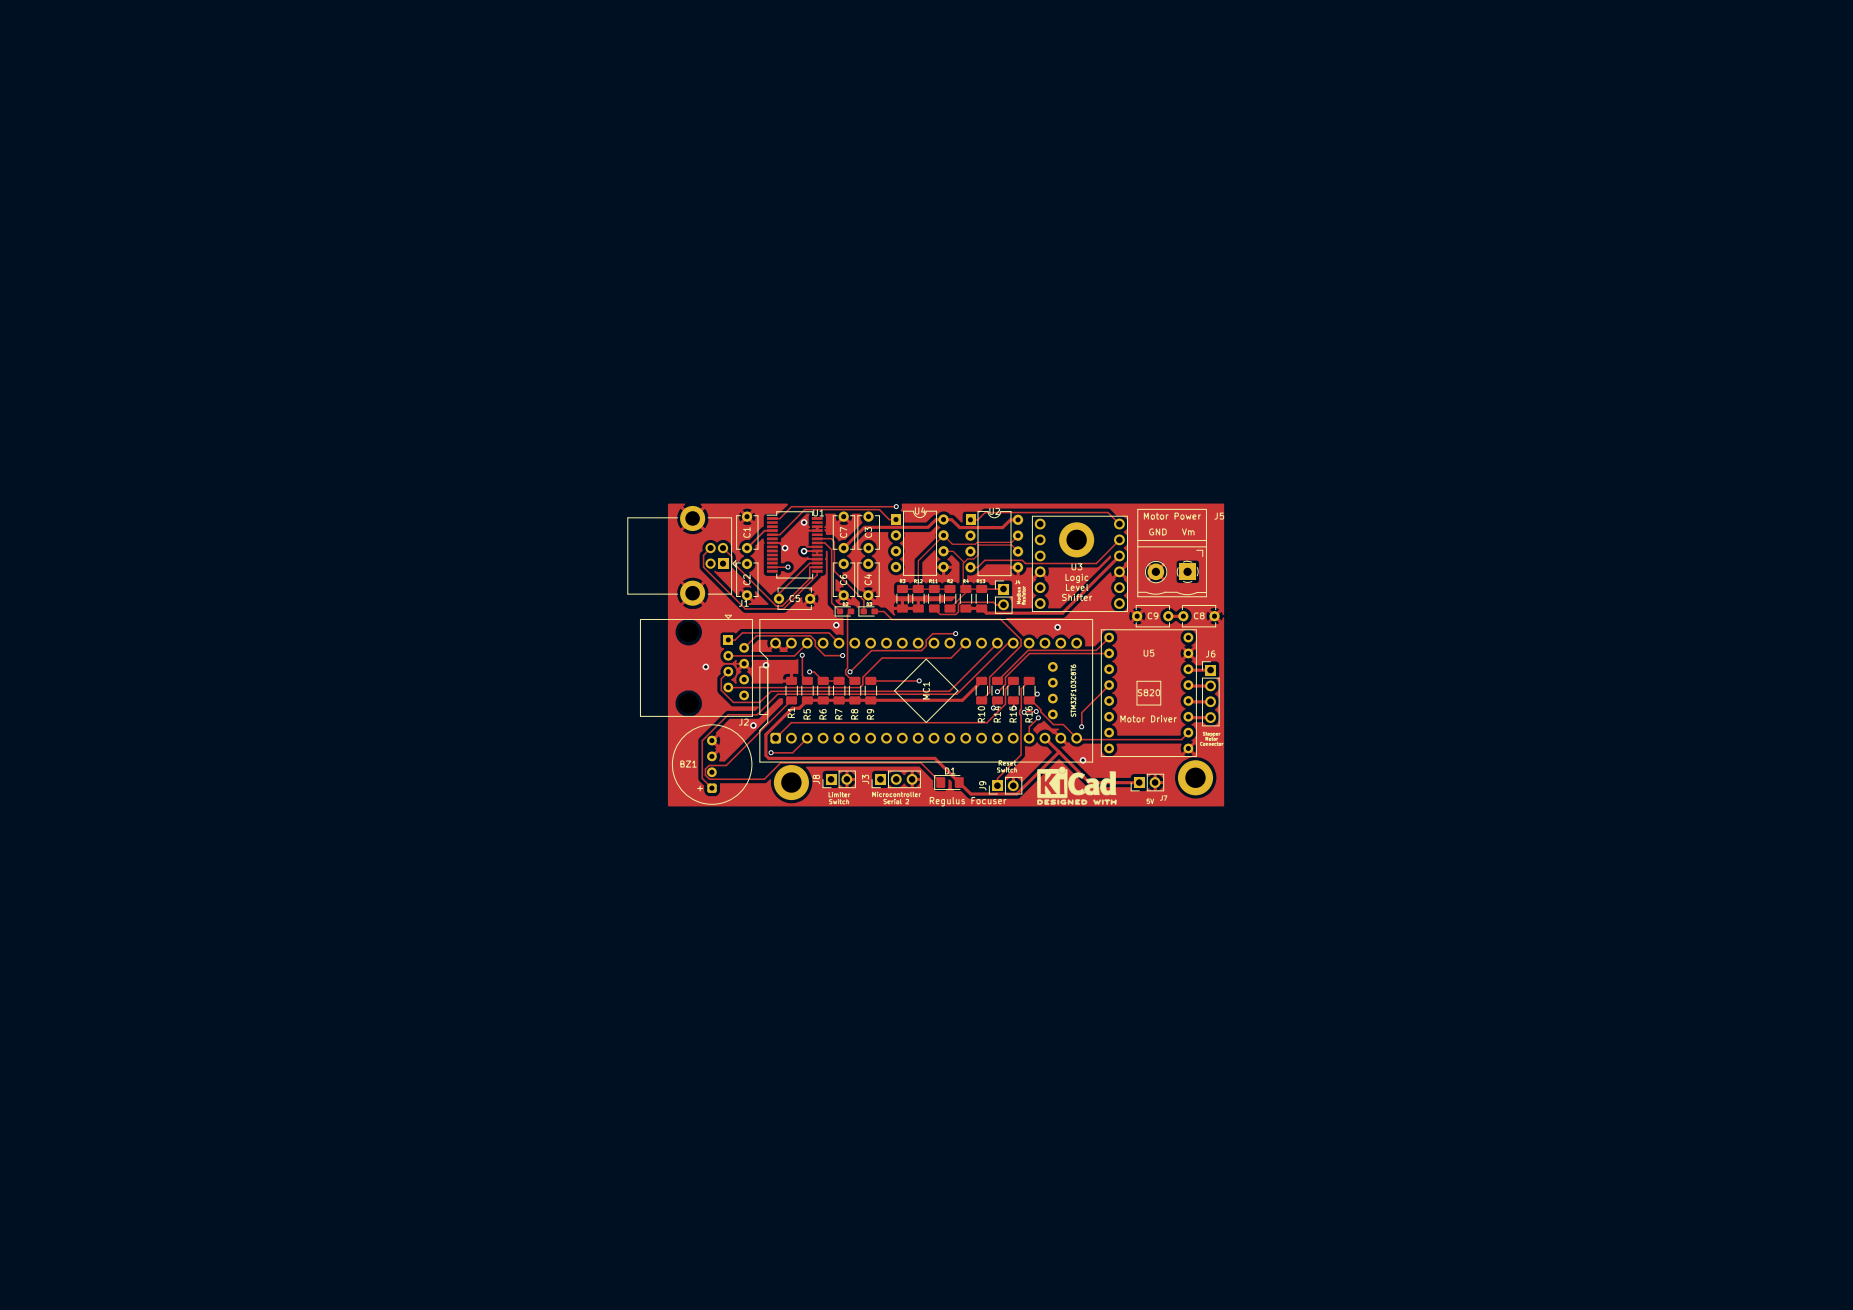
[picture p41: page 1]
