radmilofelix/ElectronicFocuser/(list of files, drawings)

Other design files:
Schematic&PCB/KiCad/Regulus Focuser-V1.1/Routing/RegulusFocuser-V1.1.dsn
Schematic&PCB/KiCad/Regulus Focuser-V1/Routing/RegulusFocuser-V1.dsn
