radmilofelix/ElectronicFocuser/Schematic&PCB/KiCad/Focuser-V0.1/ElectronicFocuser.kicad_pcb

## KiCad design Schematic&PCB/KiCad/Focuser-V0.1/ElectronicFocuser.kicad_pcb (2023-06-21, an earlier design)

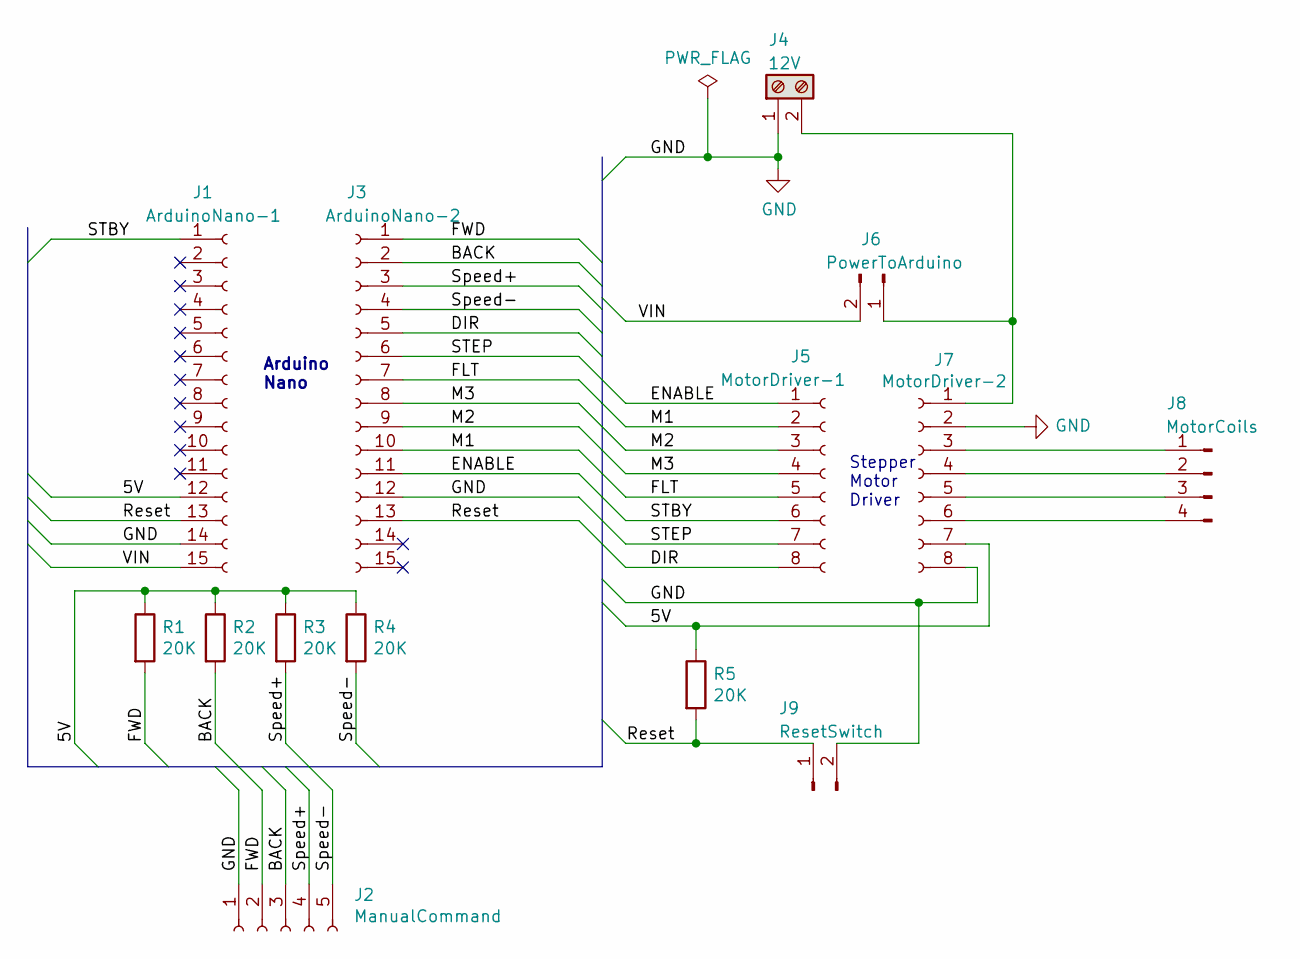
[picture p42: schematic ElectronicFocuser.kicad_sch]

Parts:
J1: ArduinoNano-1; PinHeader_1x15_P2.54mm_Vertical
J2: ManualCommand; PinHeader_1x05_P2.54mm_Vertical
J3: ArduinoNano-2; PinHeader_1x15_P2.54mm_Vertical
J4: 12V; TerminalBlock_Phoenix_MKDS-1,5-2-5.08_1x02_P5.08mm_Horizont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
J5: MotorDriver-1; PinHeader_1x08_P2.54mm_Vertical
J6: PowerToArduino; PinHeader_1x02_P2.54mm_Vertical
J7: MotorDriver-2; PinHeader_1x08_P2.54mm_Vertical
J8: MotorCoils; PinHeader_1x04_P2.54mm_Vertical
J9: ResetSwitch; PinHeader_1x02_P2.54mm_Vertical
R1, R2, R3, R4, R5: 20K; R_Axial_DIN0204_L3.6mm_D1.6mm_P7.62mm_Horizontal

Connections:
/5V: J1.12, J7.7, R1.1, R2.1, R3.1, R4.1, R5.1
/BACK: J2.3, J3.2, R2.2
/DIR: J3.5, J5.8
/ENABLE: J3.11, J5.1
/FLT: J3.7, J5.5
/FWD: J2.2, J3.1, R1.2
/M1: J3.10, J5.2
/M2: J3.9, J5.3
/M3: J3.8, J5.4
/Reset: J1.13, J3.13, J9.1, R5.2
/STBY: J1.1, J5.6
/STEP: J3.6, J5.7
/Speed+: J2.4, J3.3, R3.2
/Speed-: J2.5, J3.4, R4.2
/VIN: J1.15, J6.2
GND: J1.14, J2.1, J3.12, J4.1, J7.2, J7.8, J9.2
unnamed: J4.2, J6.1, J7.1
unnamed: J7.3, J8.1
unnamed: J7.4, J8.2
unnamed: J7.5, J8.3
unnamed: J7.6, J8.4

Notes on the sheet:
Arduino Nano
Stepper Motor Driver

Board: 2 copper layers, 14 parts (0 on the bottom side), 21 nets, no tracks yet.
