radmilofelix/ElectronicFocuser/Schematic&PCB/KiCad/Regulus Focuser-V1.1/RegulusFocuser-V1.1.kicad_pcb

## KiCad design Schematic&PCB/KiCad/Regulus Focuser-V1.1/RegulusFocuser-V1.1.kicad_pcb (2023-06-21)

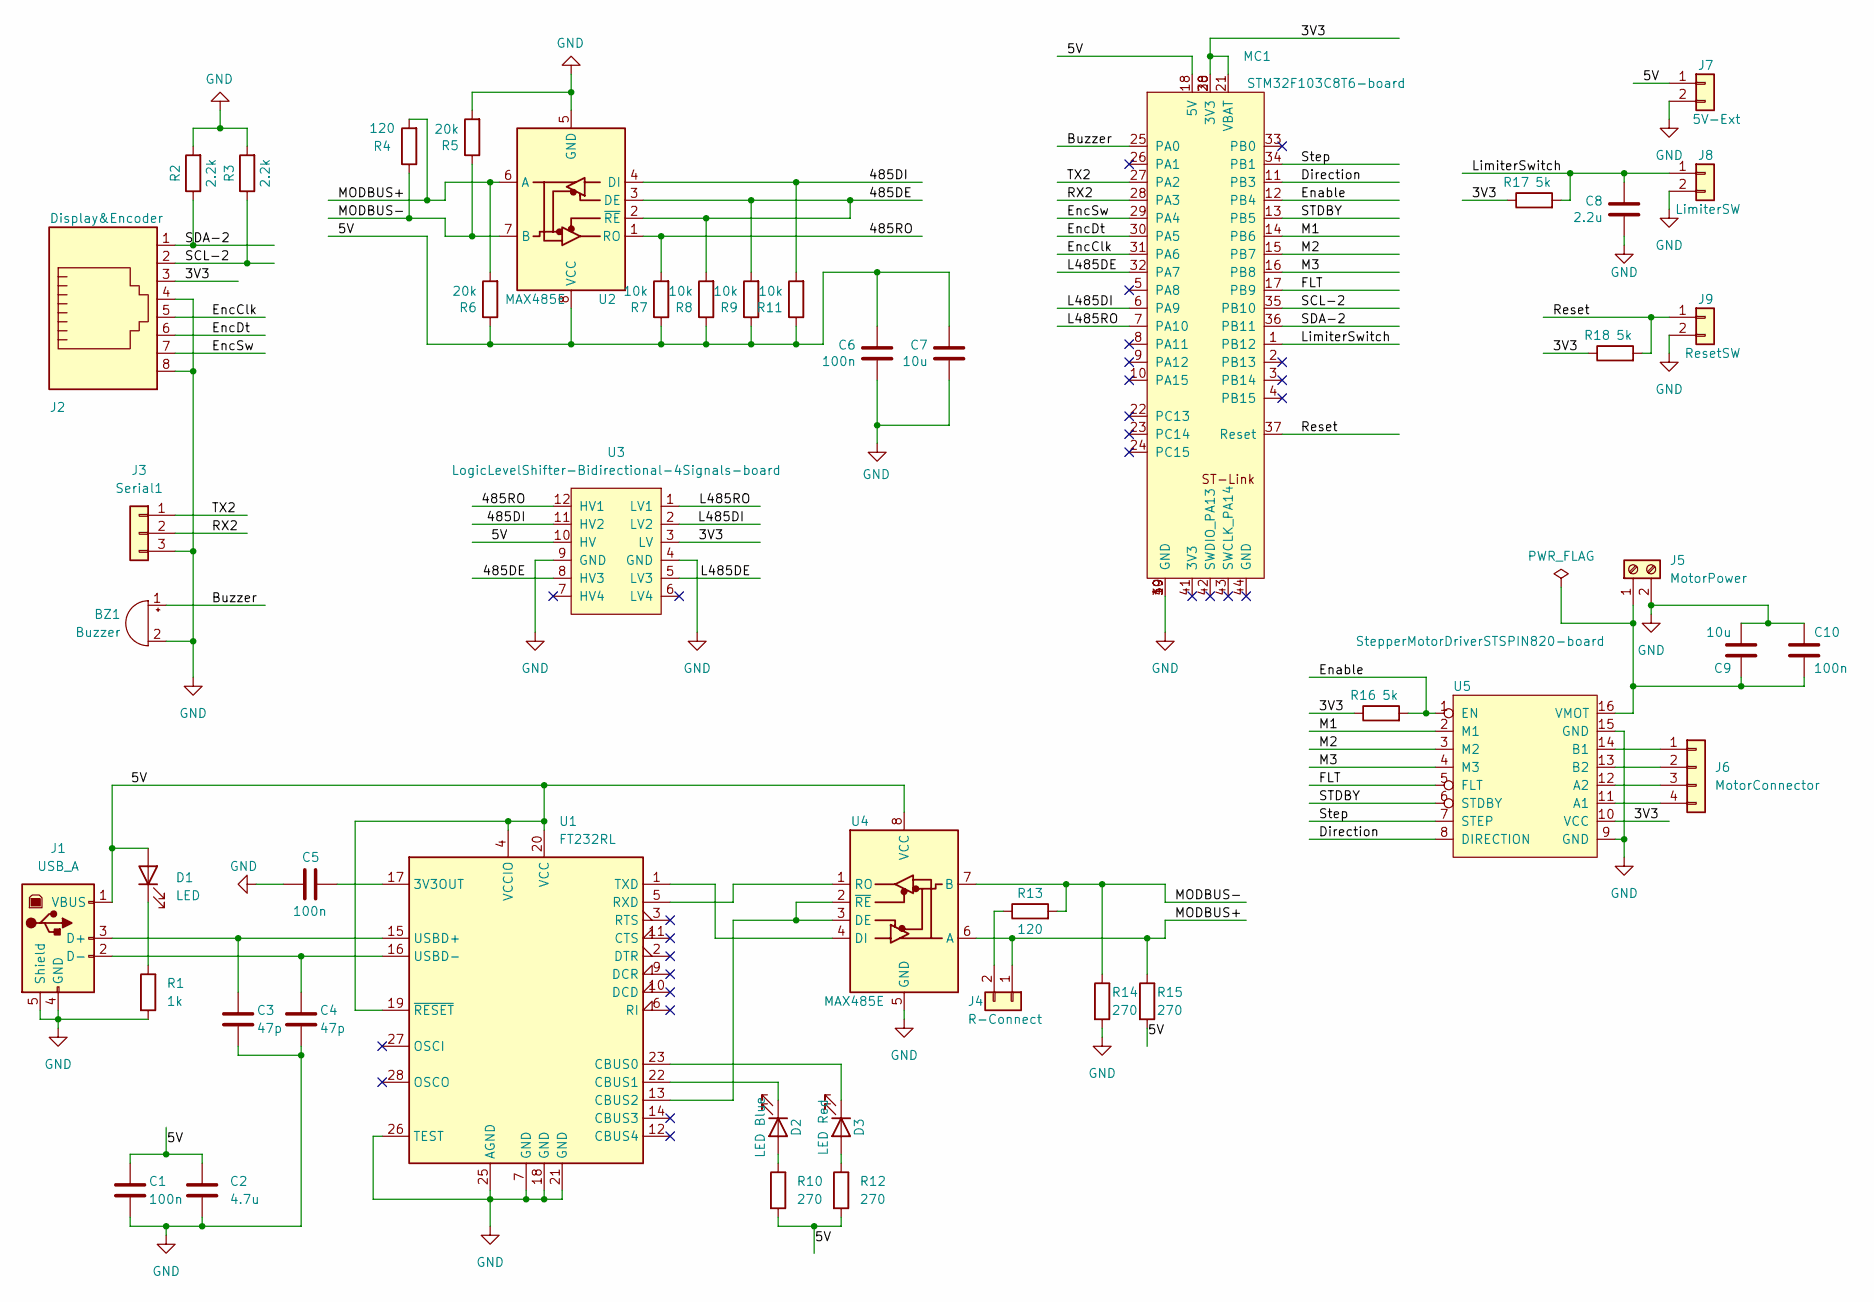
[picture p43: schematic RegulusFocuser-V1.1.kicad_sch, Regulus Electronic Focuser v1.1]

Parts:
BZ1: Buzzer; Buzzer-HSD-4pin
C1, C5, C6, C10: 100n; C_0805_2012Metric; LCSC C49678
C2: 4.7u; C_0805_2012Metric; LCSC C1779
C3, C4: 47p; C_0805_2012Metric; LCSC C14857
C7, C9: 10u; CP_EIA-3528-21_Kemet-B; LCSC C140404
C8: 2.2u; C_0805_2012Metric; LCSC C49217
D1: LED; LED_1206_3216Metric; LCSC C84270
D2: LED Blue; LED_0603_1608Metric; LCSC C84266
D3: LED Red; LED_0603_1608Metric; LCSC C2286
J1: USB_A; USB_B_Lumberg_2411_02_Horizontal
J2: Display&Encoder; RJ45_Amphenol_54602-x08_Horizontal
J3: Serial1; PinHeader_1x03_P2.54mm_Vertical
J4: R-Connect; PinHeader_1x02_P2.54mm_Vertical
J5: MotorPower; TerminalBlock_PTR_AKZ950-2_P5.08mm_Vertical
J6: MotorConnector; PinHeader_1x04_P2.54mm_Vertical
J7: 5V-Ext; PinHeader_1x02_P2.54mm_Vertical
J8: LimiterSW; PinHeader_1x02_P2.54mm_Vertical
J9: ResetSW; PinHeader_1x02_P2.54mm_Vertical
MC1: STM32F103C8T6-board; STM32F103C8T6
R1: 1k; R_1206_3216Metric; LCSC C136873
R2, R3: 2.2k; R_1206_3216Metric; LCSC C325909
R4, R13: 120; R_1206_3216Metric; LCSC C175512
R5, R6: 20k; R_1206_3216Metric; LCSC C18003
R7, R8, R9, R11: 10k; R_1206_3216Metric; LCSC C269766
R10, R12, R14, R15: 270; R_1206_3216Metric; LCSC C25366
R16, R17, R18: 5k; R_1206_3216Metric; LCSC C327044
U1: FT232RL; SSOP-28_5.3x10.2mm_P0.65mm; LCSC C8690
U2, U4: MAX485E; SOIC-8_3.9x4.9mm_P1.27mm; LCSC C19738
U3: LogicLevelShifter-Bidirectional-4Signals-board; LogicLevelShifter_Bidirectional_4Signals
U5: StepperMotorDriverSTSPIN820-board; StepperMotorDriverSTSPIN820

Connections:
/3V3: J2.3, MC1.20 (3V3), MC1.21 (VBAT), MC1.38 (3V3), R16.1, R17.1, R18.1, U3.3 (LV), U5.10 (VCC)
/5V: C1.1, C2.1, C6.1, C7.1, D1.2 (A), J1.1 (VBUS), J7.1, MC1.18 (5V), R6.1, R7.1, R8.1, R9.1, R10.2, R11.1, R12.2, R15.2, U1.4 (VCCIO), U1.19 (~RESET), U1.20 (VCC), U2.8 (VCC), U3.10 (HV), U4.8 (VCC)
/485DE: R8.2, R9.2, U2.2 (~RE), U2.3 (DE), U3.8 (HV3)
/485DI: R11.2, U2.4 (DI), U3.11 (HV2)
/485RO: R7.2, U2.1 (RO), U3.12 (HV1)
/Buzzer: BZ1.1 (-), MC1.25 (PA0)
/Direction: MC1.11 (PB3), U5.8 (DIRECTION)
/Enable: MC1.12 (PB4), R16.2, U5.1 (EN)
/EncClk: J2.5, MC1.31 (PA6)
/EncDt: J2.6, MC1.30 (PA5)
/EncSw: J2.7, MC1.29 (PA4)
/FLT: MC1.17 (PB9), U5.5 (FLT)
/L485DE: MC1.32 (PA7), U3.5 (LV3)
/L485DI: MC1.6 (PA9), U3.2 (LV2)
/L485RO: MC1.7 (PA10), U3.1 (LV1)
/LimiterSwitch: C8.1, J8.1, MC1.1 (PB12), R17.2
/M1: MC1.14 (PB6), U5.2 (M1)
/M2: MC1.15 (PB7), U5.3 (M2)
/M3: MC1.16 (PB8), U5.4 (M3)
/MODBUS+: J4.1, R4.2, R6.2, R15.1, U2.6 (A), U4.6 (A)
/MODBUS-: R4.1, R5.1, R13.2, R14.1, U2.7 (B), U4.7 (B)
/RX2: J3.2, MC1.28 (PA3)
/Reset: J9.1, MC1.37 (Reset), R18.2
/SCL-2: J2.2, MC1.35 (PB10), R3.1
/SDA-2: J2.1, MC1.36 (PB11), R2.1
/STDBY: MC1.13 (PB5), U5.6 (STDBY)
/Step: MC1.34 (PB1), U5.7 (STEP)
/TX2: J3.1, MC1.27 (PA2)
GND: BZ1.2 (+), C1.2, C2.2, C3.2, C4.2, C5.2, C6.2, C7.2, C8.2, C9.2, C10.1, J1.4 (GND), J1.5 (Shield), J2.4, J2.8, J3.3, J5.2, J7.2, J8.2, J9.2, MC1.19 (GND), MC1.39 (GND), MC1.40 (GND), R1.2, R2.2, R3.2, R5.2, R14.2, U1.7 (GND), U1.18 (GND), U1.21 (GND), U1.25 (AGND), U1.26 (TEST), U2.5 (GND), U3.4 (GND), U3.9 (GND), U4.5 (GND), U5.9 (GND), U5.15 (GND)
unnamed: C3.1, J1.3 (D+), U1.15 (USBD+)
unnamed: C4.1, J1.2 (D-), U1.16 (USBD-)
unnamed: C5.1, U1.17 (3V3OUT)
unnamed: C9.1, C10.2, J5.1, U5.16 (VMOT)
unnamed: D1.1 (K), R1.1
unnamed: D2.1 (K), U1.22 (CBUS1)
unnamed: D2.2 (A), R10.1
unnamed: D3.1 (K), U1.23 (CBUS0)
unnamed: D3.2 (A), R12.1
unnamed: J4.2, R13.1
unnamed: J6.1, U5.14 (B1)
unnamed: J6.2, U5.13 (B2)
unnamed: J6.3, U5.12 (A2)
unnamed: J6.4, U5.11 (A1)
unnamed: U1.1 (TXD), U4.4 (DI)
unnamed: U1.5 (RXD), U4.1 (RO)
unnamed: U1.13 (CBUS2), U4.2 (~RE), U4.3 (DE)

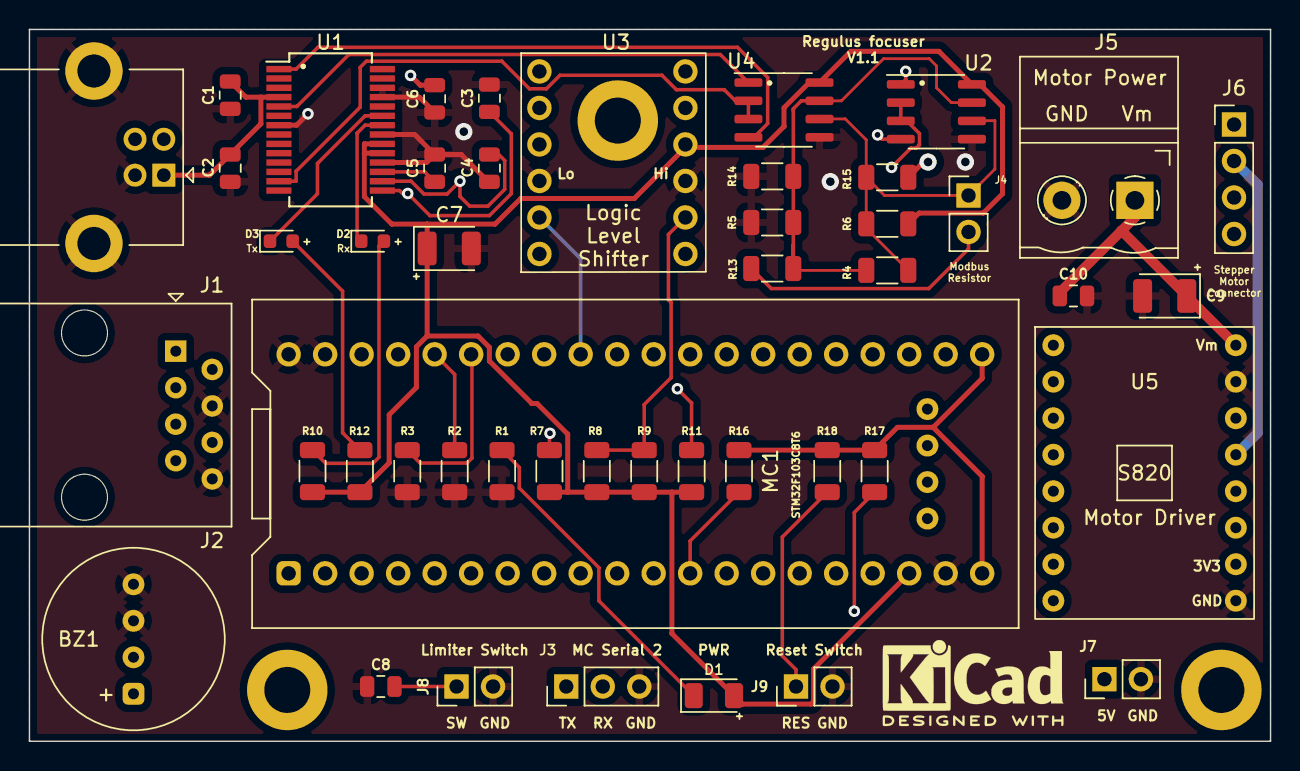
[picture p44: board RegulusFocuser-V1.1.kicad_pcb from above]

Board: 4 copper layers, 86.4 x 49.5 mm, 50 parts (0 on the bottom side), 46 nets.

Other parts of the board:
MH1, MH2, MH3: MountingHole_3.2mm_M3_DIN965_Pad
