radmilofelix/ElectronicFocuser/(commit log)

2023-08-17 I2C pullup resistors are connected wrong
    [FocuserStepper.h, main.cpp]
2023-12-25 Added mechanical designs for low profile rack and pinion focuser
    [AdapterPiece-USB_Focus_Adapter_Kit.FCStd, AdapterPlate-USB_Focus_Adapter_Kit.FCStd, AdapterPlate-USB_Focus_Adapter_Kit1.FCStd, AdapterPlate-USB_Focus_Adapter_Kit2.FCStd, AdapterRing.FCStd, Case-Lid-Body.stl, Case-Lid.FCStd, Case-MainPart-Body.stl]
2023-12-28 Added low profile rack and pimion focuser
    Added code and design for low profile rack and pinion focuser.
    Focuser fault state is now saved in the flash memory.
    [Case-Lid-Body.stl, Case-Lid.FCStd, Case-MainPart-Body.stl, Case-MainPart-Work.FCStd, Case-MainPart.FCStd, Case-MainPart.stl, Case.FCStd, Case.stl]
2024-06-15 updated INDI driver to indilib 2.8.0
